ZigEmbeddedGroup/gauntlet/kicad/boards/backplane_42hp_v1/backplane_v1.kicad_pcb

## KiCad design kicad/boards/backplane_42hp_v1/backplane_v1.kicad_pcb (2026-10-21)

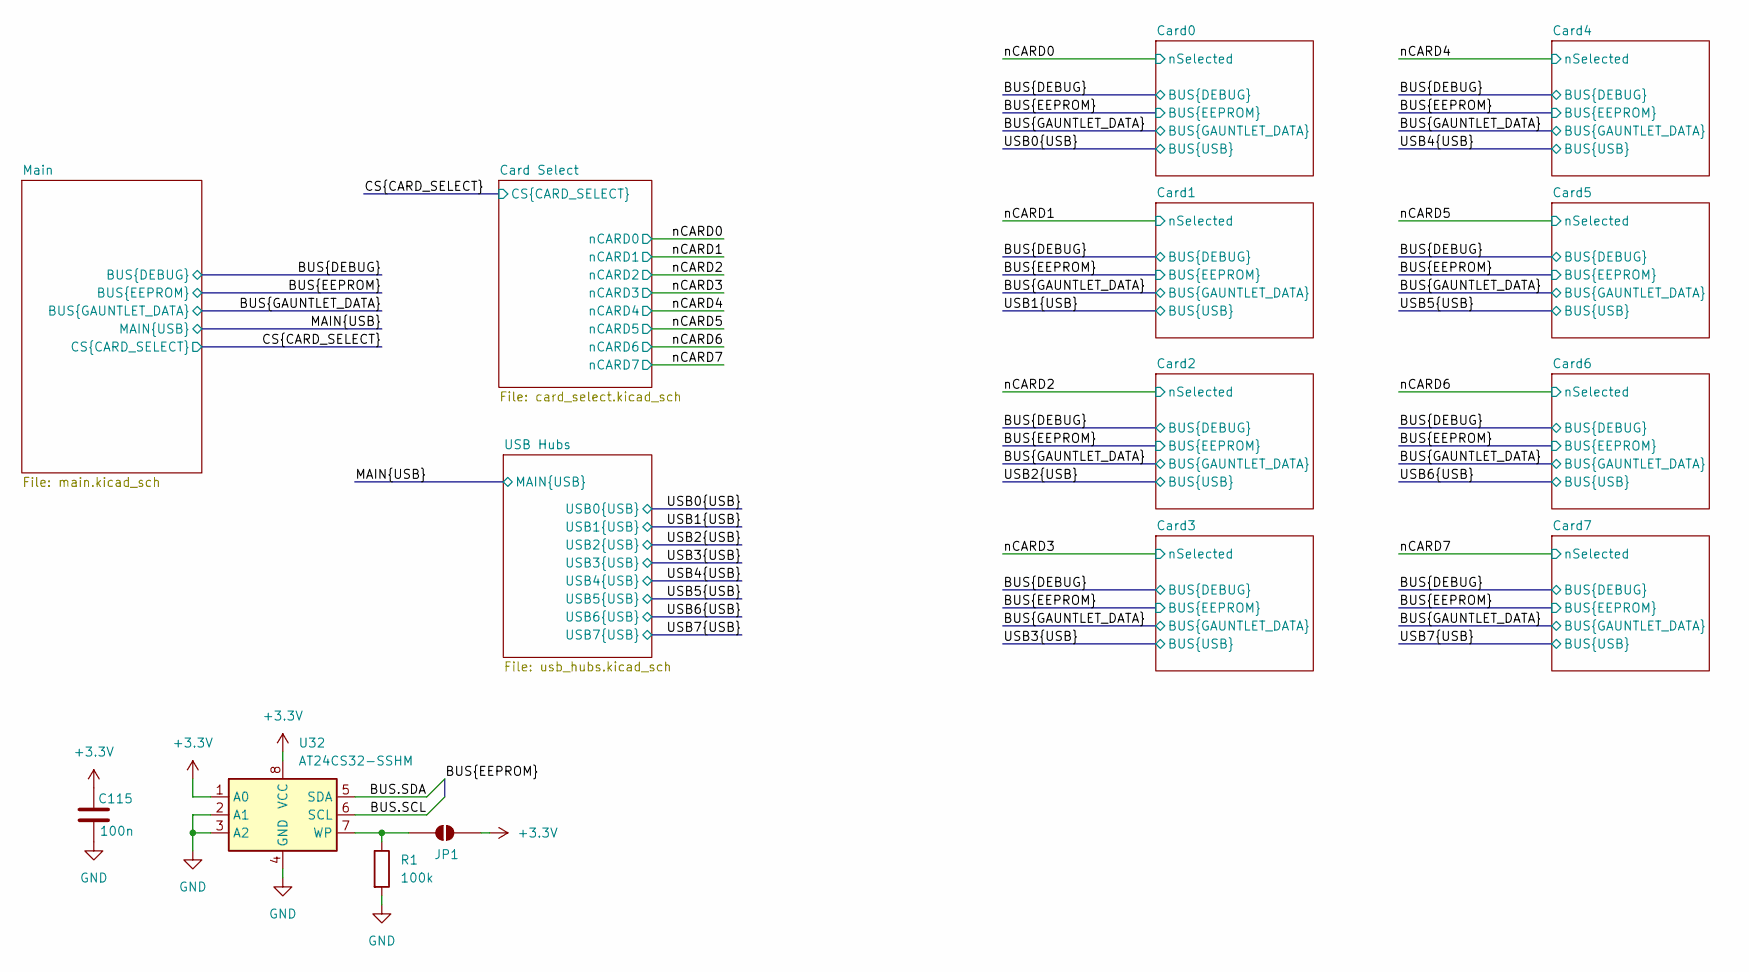
[picture p1: schematic backplane_v1.kicad_sch]

Parts:
C115: 100n; C_0603_1608Metric
JP1: SolderJumper_2_Open; SolderJumper-2_P1.3mm_Open_RoundedPad1.0x1.5mm
R1: 100k; R_0402_1005Metric
U32: AT24CS32-SSHM; SOIC-8_3.9x4.9mm_P1.27mm

Connections:
+3.3V: C115.1, JP1.2 (B), U32.1 (A0), U32.8 (VCC); also elsewhere on the board
/BUS.SCL: U32.6 (SCL); also elsewhere on the board
/BUS.SDA: U32.5 (SDA); also elsewhere on the board
GND: C115.2, R1.2, U32.2 (A1), U32.3 (A2), U32.4 (GND); also elsewhere on the board
unnamed: JP1.1 (A), R1.1, U32.7 (WP)

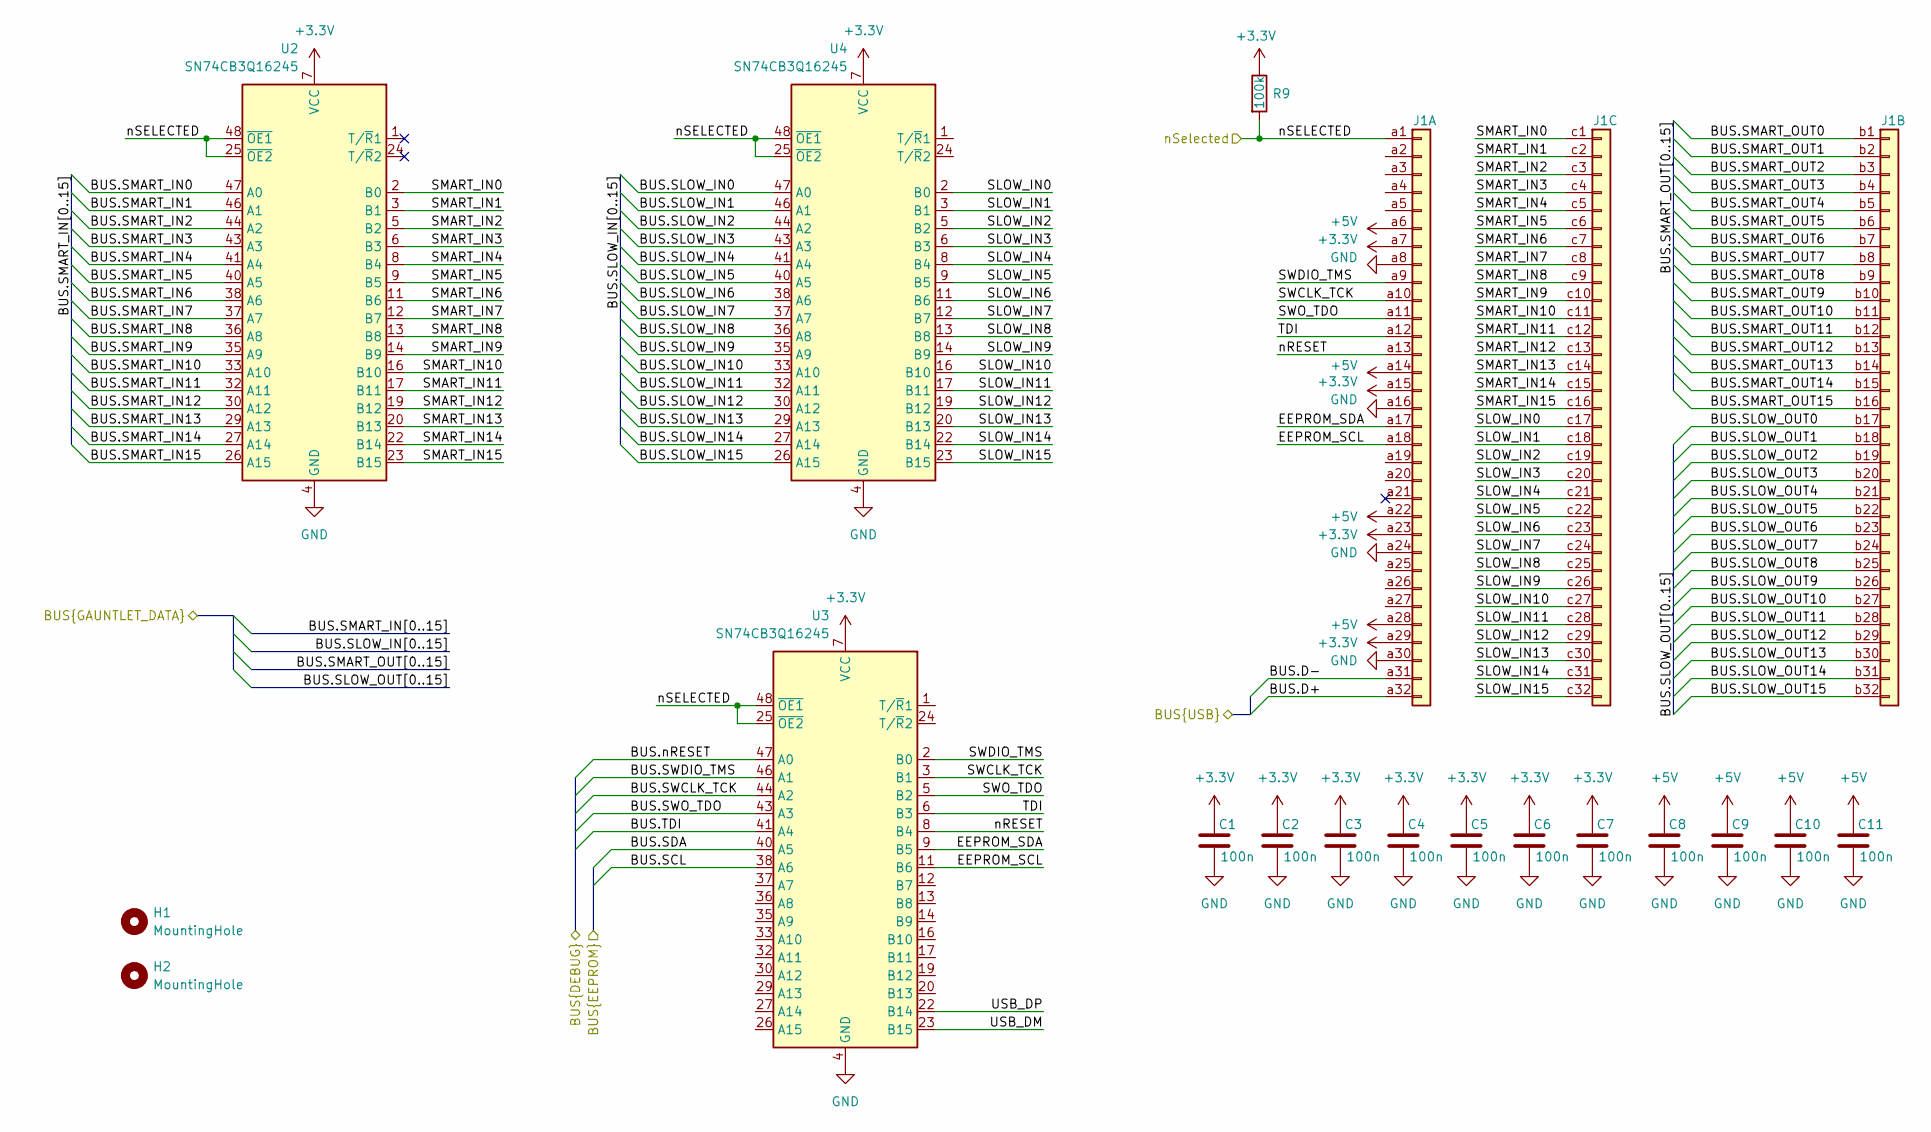
[picture p2: schematic Card Connector.kicad_sch]

Parts:
C1, C2, C3, C4, C5, C6, C7, C8, C9, C10, C11: 100n; C_0603_1608Metric
H1, H2: MountingHole; MountingHole_3.2mm_M3
J1: DIN41612_03x32_C_Split; DIN41612_C_3x32_Female_Vertical_THT
R9: 100k; R_0603_1608Metric
U2, U3, U4: SN74CB3Q16245; TSSOP-48_6.1x12.5mm_P0.5mm

Connections:
+3.3V: C1.1, C2.1, C3.1, C4.1, C5.1, C6.1, C7.1, J1.a7, J1.a15, J1.a23, J1.a29, R9.1, U2.7 (VCC), U2.18 (VCC), U2.31 (VCC), U2.42 (VCC), U3.7 (VCC), U3.18 (VCC), U3.31 (VCC), U3.42 (VCC), U4.7 (VCC), U4.18 (VCC), U4.31 (VCC), U4.42 (VCC); also elsewhere on the board
+5V: C8.1, C9.1, C10.1, C11.1, J1.a6, J1.a14, J1.a22, J1.a28; also elsewhere on the board
/BUS.SCL: U3.38 (A6); also elsewhere on the board
/BUS.SDA: U3.40 (A5); also elsewhere on the board
/BUS.SLOW_IN0: U4.47 (A0); also elsewhere on the board
/BUS.SLOW_IN1: U4.46 (A1); also elsewhere on the board
/BUS.SLOW_IN2: U4.44 (A2); also elsewhere on the board
/BUS.SLOW_IN3: U4.43 (A3); also elsewhere on the board
/BUS.SLOW_IN4: U4.41 (A4); also elsewhere on the board
/BUS.SLOW_IN5: U4.40 (A5); also elsewhere on the board
/BUS.SLOW_IN6: U4.38 (A6); also elsewhere on the board
/BUS.SLOW_IN7: U4.37 (A7); also elsewhere on the board
/BUS.SLOW_IN8: U4.36 (A8); also elsewhere on the board
/BUS.SLOW_IN9: U4.35 (A9); also elsewhere on the board
/BUS.SLOW_IN10: U4.33 (A10); also elsewhere on the board
/BUS.SLOW_IN11: U4.32 (A11); also elsewhere on the board
/BUS.SLOW_IN12: U4.30 (A12); also elsewhere on the board
/BUS.SLOW_IN13: U4.29 (A13); also elsewhere on the board
/BUS.SLOW_IN14: U4.27 (A14); also elsewhere on the board
/BUS.SLOW_IN15: U4.26 (A15); also elsewhere on the board
/BUS.SLOW_OUT0: J1.b17; also elsewhere on the board
/BUS.SLOW_OUT1: J1.b18; also elsewhere on the board
/BUS.SLOW_OUT2: J1.b19; also elsewhere on the board
/BUS.SLOW_OUT3: J1.b20; also elsewhere on the board
/BUS.SLOW_OUT4: J1.b21; also elsewhere on the board
/BUS.SLOW_OUT5: J1.b22; also elsewhere on the board
/BUS.SLOW_OUT6: J1.b23; also elsewhere on the board
/BUS.SLOW_OUT7: J1.b24; also elsewhere on the board
/BUS.SLOW_OUT8: J1.b25; also elsewhere on the board
/BUS.SLOW_OUT9: J1.b26; also elsewhere on the board
/BUS.SLOW_OUT10: J1.b27; also elsewhere on the board
/BUS.SLOW_OUT11: J1.b28; also elsewhere on the board
/BUS.SLOW_OUT12: J1.b29; also elsewhere on the board
/BUS.SLOW_OUT13: J1.b30; also elsewhere on the board
/BUS.SLOW_OUT14: J1.b31; also elsewhere on the board
/BUS.SLOW_OUT15: J1.b32; also elsewhere on the board
/BUS.SMART_IN0: U2.47 (A0); also elsewhere on the board
/BUS.SMART_IN1: U2.46 (A1); also elsewhere on the board
/BUS.SMART_IN2: U2.44 (A2); also elsewhere on the board
/BUS.SMART_IN3: U2.43 (A3); also elsewhere on the board
/BUS.SMART_IN4: U2.41 (A4); also elsewhere on the board
/BUS.SMART_IN5: U2.40 (A5); also elsewhere on the board
/BUS.SMART_IN6: U2.38 (A6); also elsewhere on the board
/BUS.SMART_IN7: U2.37 (A7); also elsewhere on the board
/BUS.SMART_IN8: U2.36 (A8); also elsewhere on the board
/BUS.SMART_IN9: U2.35 (A9); also elsewhere on the board
/BUS.SMART_IN10: U2.33 (A10); also elsewhere on the board
/BUS.SMART_IN11: U2.32 (A11); also elsewhere on the board
/BUS.SMART_IN12: U2.30 (A12); also elsewhere on the board
/BUS.SMART_IN13: U2.29 (A13); also elsewhere on the board
/BUS.SMART_IN14: U2.27 (A14); also elsewhere on the board
/BUS.SMART_IN15: U2.26 (A15); also elsewhere on the board
/BUS.SMART_OUT0: J1.b1; also elsewhere on the board
/BUS.SMART_OUT1: J1.b2; also elsewhere on the board
/BUS.SMART_OUT2: J1.b3; also elsewhere on the board
/BUS.SMART_OUT3: J1.b4; also elsewhere on the board
/BUS.SMART_OUT4: J1.b5; also elsewhere on the board
/BUS.SMART_OUT5: J1.b6; also elsewhere on the board
/BUS.SMART_OUT6: J1.b7; also elsewhere on the board
/BUS.SMART_OUT7: J1.b8; also elsewhere on the board
/BUS.SMART_OUT8: J1.b9; also elsewhere on the board
/BUS.SMART_OUT9: J1.b10; also elsewhere on the board
/BUS.SMART_OUT10: J1.b11; also elsewhere on the board
/BUS.SMART_OUT11: J1.b12; also elsewhere on the board
/BUS.SMART_OUT12: J1.b13; also elsewhere on the board
/BUS.SMART_OUT13: J1.b14; also elsewhere on the board
/BUS.SMART_OUT14: J1.b15; also elsewhere on the board
/BUS.SMART_OUT15: J1.b16; also elsewhere on the board
/BUS.SWCLK_TCK: U3.44 (A2); also elsewhere on the board
/BUS.SWDIO_TMS: U3.46 (A1); also elsewhere on the board
/BUS.SWO_TDO: U3.43 (A3); also elsewhere on the board
/BUS.TDI: U3.41 (A4); also elsewhere on the board
/BUS.nRESET: U3.47 (A0); also elsewhere on the board
/Card0/EEPROM_SCL: J1.a18, U3.11 (B6)
/Card0/EEPROM_SDA: J1.a17, U3.9 (B5)
/Card0/SLOW_IN0: J1.c17, U4.2 (B0)
/Card0/SLOW_IN1: J1.c18, U4.3 (B1)
/Card0/SLOW_IN2: J1.c19, U4.5 (B2)
/Card0/SLOW_IN3: J1.c20, U4.6 (B3)
/Card0/SLOW_IN4: J1.c21, U4.8 (B4)
/Card0/SLOW_IN5: J1.c22, U4.9 (B5)
/Card0/SLOW_IN6: J1.c23, U4.11 (B6)
/Card0/SLOW_IN7: J1.c24, U4.12 (B7)
/Card0/SLOW_IN8: J1.c25, U4.13 (B8)
/Card0/SLOW_IN9: J1.c26, U4.14 (B9)
/Card0/SLOW_IN10: J1.c27, U4.16 (B10)
/Card0/SLOW_IN11: J1.c28, U4.17 (B11)
/Card0/SLOW_IN12: J1.c29, U4.19 (B12)
/Card0/SLOW_IN13: J1.c30, U4.20 (B13)
/Card0/SLOW_IN14: J1.c31, U4.22 (B14)
/Card0/SLOW_IN15: J1.c32, U4.23 (B15)
/Card0/SMART_IN0: J1.c1, U2.2 (B0)
/Card0/SMART_IN1: J1.c2, U2.3 (B1)
/Card0/SMART_IN2: J1.c3, U2.5 (B2)
/Card0/SMART_IN3: J1.c4, U2.6 (B3)
/Card0/SMART_IN4: J1.c5, U2.8 (B4)
/Card0/SMART_IN5: J1.c6, U2.9 (B5)
/Card0/SMART_IN6: J1.c7, U2.11 (B6)
/Card0/SMART_IN7: J1.c8, U2.12 (B7)
/Card0/SMART_IN8: J1.c9, U2.13 (B8)
/Card0/SMART_IN9: J1.c10, U2.14 (B9)
/Card0/SMART_IN10: J1.c11, U2.16 (B10)
/Card0/SMART_IN11: J1.c12, U2.17 (B11)
/Card0/SMART_IN12: J1.c13, U2.19 (B12)
/Card0/SMART_IN13: J1.c14, U2.20 (B13)
/Card0/SMART_IN14: J1.c15, U2.22 (B14)
/Card0/SMART_IN15: J1.c16, U2.23 (B15)
/Card0/SWCLK_TCK: J1.a10, U3.3 (B1)
/Card0/SWDIO_TMS: J1.a9, U3.2 (B0)
/Card0/SWO_TDO: J1.a11, U3.5 (B2)
/Card0/TDI: J1.a12, U3.6 (B3)
/Card0/USB_DM: U3.23 (B15)
/Card0/USB_DP: U3.22 (B14)
/Card0/nRESET: J1.a13, U3.8 (B4)
/USB0.D+: J1.a32; also elsewhere on the board
/USB0.D-: J1.a31; also elsewhere on the board
/nCARD0: J1.a1, R9.2, U2.25 (~OE2), U2.48 (~OE1), U3.25 (~OE2), U3.48 (~OE1), U4.25 (~OE2), U4.48 (~OE1); also elsewhere on the board
GND: C1.2, C2.2, C3.2, C4.2, C5.2, C6.2, C7.2, C8.2, C9.2, C10.2, C11.2, J1.a8, J1.a16, J1.a24, J1.a30, U2.4 (GND), U2.10 (GND), U2.15 (GND), U2.21 (GND), U2.28 (GND), U2.34 (GND), U2.39 (GND), U2.45 (GND), U3.4 (GND), U3.10 (GND), U3.15 (GND), U3.21 (GND), U3.28 (GND), U3.34 (GND), U3.39 (GND), U3.45 (GND), U4.4 (GND), U4.10 (GND), U4.15 (GND), U4.21 (GND), U4.28 (GND), U4.34 (GND), U4.39 (GND), U4.45 (GND); also elsewhere on the board

Parts of its further copies:
C16, C17, C18, C19, C20, C21, C22, C23, C24, C25, C26, C27, C28, C29, C30, C31, C32, C33, C34, C35, C36, C37, C38, C39, C40, C41, C42, C43, C44, C45, C46, C47, C48, C49, C50, C51, C52, C53, C54, C55, C56, C57, C58, C59, C60, C61, C62, C63, C64, C65, C66, C67, C68, C69, C70, C71, C72, C73, C74, C75, C76, C77, C78, C79, C80, C81, C82, C83, C84, C85, C86, C87, C88, C89, C90, C91, C92: 100n; C_0603_1608Metric
H3, H4, H5, H6, H7, H8, H9, H10, H11, H12, H13, H14, H15, H16: MountingHole; MountingHole_3.2mm_M3
J3, J4, J5, J6, J7, J8, J9: DIN41612_03x32_C_Split; DIN41612_C_3x32_Female_Vertical_THT
R10, R11, R12, R13, R14, R15, R16: 100k; R_0603_1608Metric
U5, U6, U7, U11, U12, U13, U14, U15, U16, U17, U18, U19, U20, U21, U22, U23, U24, U25, U26, U27, U28: SN74CB3Q16245; TSSOP-48_6.1x12.5mm_P0.5mm

Connections of its further copies:
+3.3V: C16.1, C17.1, C18.1, C19.1, C20.1, C21.1, C22.1, C27.1, C28.1, C29.1, C30.1, C31.1, C32.1, C33.1, C38.1, C39.1, C40.1, C41.1, C42.1, C43.1, C44.1, C49.1, C50.1, C51.1, C52.1, C53.1, C54.1, C55.1, C60.1, C61.1, C62.1, C63.1, C64.1, C65.1, C66.1, C71.1, C72.1, C73.1, C74.1, C75.1, C76.1, C77.1, C82.1, C83.1, C84.1, C85.1, C86.1, C87.1, C88.1, J3.a7, J3.a15, J3.a23, J3.a29, J4.a7, J4.a15, J4.a23, J4.a29, J5.a7, J5.a15, J5.a23, J5.a29, J6.a7, J6.a15, J6.a23, J6.a29, J7.a7, J7.a15, J7.a23, J7.a29, J8.a7, J8.a15, J8.a23, J8.a29, J9.a7, J9.a15, J9.a23, J9.a29, R10.1, R11.1, R12.1, R13.1, R14.1, R15.1, R16.1, U5.7 (VCC), U5.18 (VCC), U5.31 (VCC), U5.42 (VCC), U6.7 (VCC), U6.18 (VCC), U6.31 (VCC), U6.42 (VCC), U7.7 (VCC), U7.18 (VCC), U7.31 (VCC), U7.42 (VCC), U11.7 (VCC), U11.18 (VCC), U11.31 (VCC), U11.42 (VCC), U12.7 (VCC), U12.18 (VCC), U12.31 (VCC), U12.42 (VCC), U13.7 (VCC), U13.18 (VCC), U13.31 (VCC), U13.42 (VCC), U14.7 (VCC), U14.18 (VCC), U14.31 (VCC), U14.42 (VCC), U15.7 (VCC), U15.18 (VCC), U15.31 (VCC), U15.42 (VCC), U16.7 (VCC), U16.18 (VCC), U16.31 (VCC), U16.42 (VCC), U17.7 (VCC), U17.18 (VCC), U17.31 (VCC), U17.42 (VCC), U18.7 (VCC), U18.18 (VCC), U18.31 (VCC), U18.42 (VCC), U19.7 (VCC), U19.18 (VCC), U19.31 (VCC), U19.42 (VCC), U20.7 (VCC), U20.18 (VCC), U20.31 (VCC), U20.42 (VCC), U21.7 (VCC), U21.18 (VCC), U21.31 (VCC), U21.42 (VCC), U22.7 (VCC), U22.18 (VCC), U22.31 (VCC), U22.42 (VCC), U23.7 (VCC), U23.18 (VCC), U23.31 (VCC), U23.42 (VCC), U24.7 (VCC), U24.18 (VCC), U24.31 (VCC), U24.42 (VCC), U25.7 (VCC), U25.18 (VCC), U25.31 (VCC), U25.42 (VCC), U26.7 (VCC), U26.18 (VCC), U26.31 (VCC), U26.42 (VCC), U27.7 (VCC), U27.18 (VCC), U27.31 (VCC), U27.42 (VCC), U28.7 (VCC), U28.18 (VCC), U28.31 (VCC), U28.42 (VCC); also elsewhere on the board
+5V: C23.1, C24.1, C25.1, C26.1, C34.1, C35.1, C36.1, C37.1, C45.1, C46.1, C47.1, C48.1, C56.1, C57.1, C58.1, C59.1, C67.1, C68.1, C69.1, C70.1, C78.1, C79.1, C80.1, C81.1, C89.1, C90.1, C91.1, C92.1, J3.a6, J3.a14, J3.a22, J3.a28, J4.a6, J4.a14, J4.a22, J4.a28, J5.a6, J5.a14, J5.a22, J5.a28, J6.a6, J6.a14, J6.a22, J6.a28, J7.a6, J7.a14, J7.a22, J7.a28, J8.a6, J8.a14, J8.a22, J8.a28, J9.a6, J9.a14, J9.a22, J9.a28; also elsewhere on the board
/BUS.SCL: U6.38 (A6), U12.38 (A6), U15.38 (A6), U18.38 (A6), U21.38 (A6), U24.38 (A6), U27.38 (A6); also elsewhere on the board
/BUS.SDA: U6.40 (A5), U12.40 (A5), U15.40 (A5), U18.40 (A5), U21.40 (A5), U24.40 (A5), U27.40 (A5); also elsewhere on the board
/BUS.SLOW_IN0: U7.47 (A0), U13.47 (A0), U16.47 (A0), U19.47 (A0), U22.47 (A0), U25.47 (A0), U28.47 (A0); also elsewhere on the board
/BUS.SLOW_IN1: U7.46 (A1), U13.46 (A1), U16.46 (A1), U19.46 (A1), U22.46 (A1), U25.46 (A1), U28.46 (A1); also elsewhere on the board
/BUS.SLOW_IN2: U7.44 (A2), U13.44 (A2), U16.44 (A2), U19.44 (A2), U22.44 (A2), U25.44 (A2), U28.44 (A2); also elsewhere on the board
/BUS.SLOW_IN3: U7.43 (A3), U13.43 (A3), U16.43 (A3), U19.43 (A3), U22.43 (A3), U25.43 (A3), U28.43 (A3); also elsewhere on the board
/BUS.SLOW_IN4: U7.41 (A4), U13.41 (A4), U16.41 (A4), U19.41 (A4), U22.41 (A4), U25.41 (A4), U28.41 (A4); also elsewhere on the board
/BUS.SLOW_IN5: U7.40 (A5), U13.40 (A5), U16.40 (A5), U19.40 (A5), U22.40 (A5), U25.40 (A5), U28.40 (A5); also elsewhere on the board
/BUS.SLOW_IN6: U7.38 (A6), U13.38 (A6), U16.38 (A6), U19.38 (A6), U22.38 (A6), U25.38 (A6), U28.38 (A6); also elsewhere on the board
/BUS.SLOW_IN7: U7.37 (A7), U13.37 (A7), U16.37 (A7), U19.37 (A7), U22.37 (A7), U25.37 (A7), U28.37 (A7); also elsewhere on the board
/BUS.SLOW_IN8: U7.36 (A8), U13.36 (A8), U16.36 (A8), U19.36 (A8), U22.36 (A8), U25.36 (A8), U28.36 (A8); also elsewhere on the board
/BUS.SLOW_IN9: U7.35 (A9), U13.35 (A9), U16.35 (A9), U19.35 (A9), U22.35 (A9), U25.35 (A9), U28.35 (A9); also elsewhere on the board
/BUS.SLOW_IN10: U7.33 (A10), U13.33 (A10), U16.33 (A10), U19.33 (A10), U22.33 (A10), U25.33 (A10), U28.33 (A10); also elsewhere on the board
/BUS.SLOW_IN11: U7.32 (A11), U13.32 (A11), U16.32 (A11), U19.32 (A11), U22.32 (A11), U25.32 (A11), U28.32 (A11); also elsewhere on the board
/BUS.SLOW_IN12: U7.30 (A12), U13.30 (A12), U16.30 (A12), U19.30 (A12), U22.30 (A12), U25.30 (A12), U28.30 (A12); also elsewhere on the board
/BUS.SLOW_IN13: U7.29 (A13), U13.29 (A13), U16.29 (A13), U19.29 (A13), U22.29 (A13), U25.29 (A13), U28.29 (A13); also elsewhere on the board
/BUS.SLOW_IN14: U7.27 (A14), U13.27 (A14), U16.27 (A14), U19.27 (A14), U22.27 (A14), U25.27 (A14), U28.27 (A14); also elsewhere on the board
/BUS.SLOW_IN15: U7.26 (A15), U13.26 (A15), U16.26 (A15), U19.26 (A15), U22.26 (A15), U25.26 (A15), U28.26 (A15); also elsewhere on the board
/BUS.SLOW_OUT0: J3.b17, J4.b17, J5.b17, J6.b17, J7.b17, J8.b17, J9.b17; also elsewhere on the board
/BUS.SLOW_OUT1: J3.b18, J4.b18, J5.b18, J6.b18, J7.b18, J8.b18, J9.b18; also elsewhere on the board
/BUS.SLOW_OUT2: J3.b19, J4.b19, J5.b19, J6.b19, J7.b19, J8.b19, J9.b19; also elsewhere on the board
/BUS.SLOW_OUT3: J3.b20, J4.b20, J5.b20, J6.b20, J7.b20, J8.b20, J9.b20; also elsewhere on the board
/BUS.SLOW_OUT4: J3.b21, J4.b21, J5.b21, J6.b21, J7.b21, J8.b21, J9.b21; also elsewhere on the board
/BUS.SLOW_OUT5: J3.b22, J4.b22, J5.b22, J6.b22, J7.b22, J8.b22, J9.b22; also elsewhere on the board
/BUS.SLOW_OUT6: J3.b23, J4.b23, J5.b23, J6.b23, J7.b23, J8.b23, J9.b23; also elsewhere on the board
/BUS.SLOW_OUT7: J3.b24, J4.b24, J5.b24, J6.b24, J7.b24, J8.b24, J9.b24; also elsewhere on the board
/BUS.SLOW_OUT8: J3.b25, J4.b25, J5.b25, J6.b25, J7.b25, J8.b25, J9.b25; also elsewhere on the board
/BUS.SLOW_OUT9: J3.b26, J4.b26, J5.b26, J6.b26, J7.b26, J8.b26, J9.b26; also elsewhere on the board
/BUS.SLOW_OUT10: J3.b27, J4.b27, J5.b27, J6.b27, J7.b27, J8.b27, J9.b27; also elsewhere on the board
/BUS.SLOW_OUT11: J3.b28, J4.b28, J5.b28, J6.b28, J7.b28, J8.b28, J9.b28; also elsewhere on the board
/BUS.SLOW_OUT12: J3.b29, J4.b29, J5.b29, J6.b29, J7.b29, J8.b29, J9.b29; also elsewhere on the board
/BUS.SLOW_OUT13: J3.b30, J4.b30, J5.b30, J6.b30, J7.b30, J8.b30, J9.b30; also elsewhere on the board
/BUS.SLOW_OUT14: J3.b31, J4.b31, J5.b31, J6.b31, J7.b31, J8.b31, J9.b31; also elsewhere on the board
/BUS.SLOW_OUT15: J3.b32, J4.b32, J5.b32, J6.b32, J7.b32, J8.b32, J9.b32; also elsewhere on the board
/BUS.SMART_IN0: U5.47 (A0), U11.47 (A0), U14.47 (A0), U17.47 (A0), U20.47 (A0), U23.47 (A0), U26.47 (A0); also elsewhere on the board
/BUS.SMART_IN1: U5.46 (A1), U11.46 (A1), U14.46 (A1), U17.46 (A1), U20.46 (A1), U23.46 (A1), U26.46 (A1); also elsewhere on the board
/BUS.SMART_IN2: U5.44 (A2), U11.44 (A2), U14.44 (A2), U17.44 (A2), U20.44 (A2), U23.44 (A2), U26.44 (A2); also elsewhere on the board
/BUS.SMART_IN3: U5.43 (A3), U11.43 (A3), U14.43 (A3), U17.43 (A3), U20.43 (A3), U23.43 (A3), U26.43 (A3); also elsewhere on the board
/BUS.SMART_IN4: U5.41 (A4), U11.41 (A4), U14.41 (A4), U17.41 (A4), U20.41 (A4), U23.41 (A4), U26.41 (A4); also elsewhere on the board
/BUS.SMART_IN5: U5.40 (A5), U11.40 (A5), U14.40 (A5), U17.40 (A5), U20.40 (A5), U23.40 (A5), U26.40 (A5); also elsewhere on the board
/BUS.SMART_IN6: U5.38 (A6), U11.38 (A6), U14.38 (A6), U17.38 (A6), U20.38 (A6), U23.38 (A6), U26.38 (A6); also elsewhere on the board
/BUS.SMART_IN7: U5.37 (A7), U11.37 (A7), U14.37 (A7), U17.37 (A7), U20.37 (A7), U23.37 (A7), U26.37 (A7); also elsewhere on the board
/BUS.SMART_IN8: U5.36 (A8), U11.36 (A8), U14.36 (A8), U17.36 (A8), U20.36 (A8), U23.36 (A8), U26.36 (A8); also elsewhere on the board
/BUS.SMART_IN9: U5.35 (A9), U11.35 (A9), U14.35 (A9), U17.35 (A9), U20.35 (A9), U23.35 (A9), U26.35 (A9); also elsewhere on the board
/BUS.SMART_IN10: U5.33 (A10), U11.33 (A10), U14.33 (A10), U17.33 (A10), U20.33 (A10), U23.33 (A10), U26.33 (A10); also elsewhere on the board
/BUS.SMART_IN11: U5.32 (A11), U11.32 (A11), U14.32 (A11), U17.32 (A11), U20.32 (A11), U23.32 (A11), U26.32 (A11); also elsewhere on the board
/BUS.SMART_IN12: U5.30 (A12), U11.30 (A12), U14.30 (A12), U17.30 (A12), U20.30 (A12), U23.30 (A12), U26.30 (A12); also elsewhere on the board
/BUS.SMART_IN13: U5.29 (A13), U11.29 (A13), U14.29 (A13), U17.29 (A13), U20.29 (A13), U23.29 (A13), U26.29 (A13); also elsewhere on the board
/BUS.SMART_IN14: U5.27 (A14), U11.27 (A14), U14.27 (A14), U17.27 (A14), U20.27 (A14), U23.27 (A14), U26.27 (A14); also elsewhere on the board
/BUS.SMART_IN15: U5.26 (A15), U11.26 (A15), U14.26 (A15), U17.26 (A15), U20.26 (A15), U23.26 (A15), U26.26 (A15); also elsewhere on the board
/BUS.SMART_OUT0: J3.b1, J4.b1, J5.b1, J6.b1, J7.b1, J8.b1, J9.b1; also elsewhere on the board
/BUS.SMART_OUT1: J3.b2, J4.b2, J5.b2, J6.b2, J7.b2, J8.b2, J9.b2; also elsewhere on the board
/BUS.SMART_OUT2: J3.b3, J4.b3, J5.b3, J6.b3, J7.b3, J8.b3, J9.b3; also elsewhere on the board
/BUS.SMART_OUT3: J3.b4, J4.b4, J5.b4, J6.b4, J7.b4, J8.b4, J9.b4; also elsewhere on the board
/BUS.SMART_OUT4: J3.b5, J4.b5, J5.b5, J6.b5, J7.b5, J8.b5, J9.b5; also elsewhere on the board
/BUS.SMART_OUT5: J3.b6, J4.b6, J5.b6, J6.b6, J7.b6, J8.b6, J9.b6; also elsewhere on the board
/BUS.SMART_OUT6: J3.b7, J4.b7, J5.b7, J6.b7, J7.b7, J8.b7, J9.b7; also elsewhere on the board
/BUS.SMART_OUT7: J3.b8, J4.b8, J5.b8, J6.b8, J7.b8, J8.b8, J9.b8; also elsewhere on the board
/BUS.SMART_OUT8: J3.b9, J4.b9, J5.b9, J6.b9, J7.b9, J8.b9, J9.b9; also elsewhere on the board
/BUS.SMART_OUT9: J3.b10, J4.b10, J5.b10, J6.b10, J7.b10, J8.b10, J9.b10; also elsewhere on the board
/BUS.SMART_OUT10: J3.b11, J4.b11, J5.b11, J6.b11, J7.b11, J8.b11, J9.b11; also elsewhere on the board
/BUS.SMART_OUT11: J3.b12, J4.b12, J5.b12, J6.b12, J7.b12, J8.b12, J9.b12; also elsewhere on the board
/BUS.SMART_OUT12: J3.b13, J4.b13, J5.b13, J6.b13, J7.b13, J8.b13, J9.b13; also elsewhere on the board
/BUS.SMART_OUT13: J3.b14, J4.b14, J5.b14, J6.b14, J7.b14, J8.b14, J9.b14; also elsewhere on the board
/BUS.SMART_OUT14: J3.b15, J4.b15, J5.b15, J6.b15, J7.b15, J8.b15, J9.b15; also elsewhere on the board
/BUS.SMART_OUT15: J3.b16, J4.b16, J5.b16, J6.b16, J7.b16, J8.b16, J9.b16; also elsewhere on the board
/BUS.SWCLK_TCK: U6.44 (A2), U12.44 (A2), U15.44 (A2), U18.44 (A2), U21.44 (A2), U24.44 (A2), U27.44 (A2); also elsewhere on the board
/BUS.SWDIO_TMS: U6.46 (A1), U12.46 (A1), U15.46 (A1), U18.46 (A1), U21.46 (A1), U24.46 (A1), U27.46 (A1); also elsewhere on the board
/BUS.SWO_TDO: U6.43 (A3), U12.43 (A3), U15.43 (A3), U18.43 (A3), U21.43 (A3), U24.43 (A3), U27.43 (A3); also elsewhere on the board
/BUS.TDI: U6.41 (A4), U12.41 (A4), U15.41 (A4), U18.41 (A4), U21.41 (A4), U24.41 (A4), U27.41 (A4); also elsewhere on the board
/BUS.nRESET: U6.47 (A0), U12.47 (A0), U15.47 (A0), U18.47 (A0), U21.47 (A0), U24.47 (A0), U27.47 (A0); also elsewhere on the board
/Card1/EEPROM_SCL: J3.a18, U6.11 (B6)
/Card1/EEPROM_SDA: J3.a17, U6.9 (B5)
/Card1/SLOW_IN0: J3.c17, U7.2 (B0)
/Card1/SLOW_IN1: J3.c18, U7.3 (B1)
/Card1/SLOW_IN2: J3.c19, U7.5 (B2)
/Card1/SLOW_IN3: J3.c20, U7.6 (B3)
/Card1/SLOW_IN4: J3.c21, U7.8 (B4)
/Card1/SLOW_IN5: J3.c22, U7.9 (B5)
/Card1/SLOW_IN6: J3.c23, U7.11 (B6)
/Card1/SLOW_IN7: J3.c24, U7.12 (B7)
/Card1/SLOW_IN8: J3.c25, U7.13 (B8)
/Card1/SLOW_IN9: J3.c26, U7.14 (B9)
/Card1/SLOW_IN10: J3.c27, U7.16 (B10)
/Card1/SLOW_IN11: J3.c28, U7.17 (B11)
/Card1/SLOW_IN12: J3.c29, U7.19 (B12)
/Card1/SLOW_IN13: J3.c30, U7.20 (B13)
/Card1/SLOW_IN14: J3.c31, U7.22 (B14)
/Card1/SLOW_IN15: J3.c32, U7.23 (B15)
/Card1/SMART_IN0: J3.c1, U5.2 (B0)
/Card1/SMART_IN1: J3.c2, U5.3 (B1)
/Card1/SMART_IN2: J3.c3, U5.5 (B2)
/Card1/SMART_IN3: J3.c4, U5.6 (B3)
/Card1/SMART_IN4: J3.c5, U5.8 (B4)
/Card1/SMART_IN5: J3.c6, U5.9 (B5)
/Card1/SMART_IN6: J3.c7, U5.11 (B6)
/Card1/SMART_IN7: J3.c8, U5.12 (B7)
/Card1/SMART_IN8: J3.c9, U5.13 (B8)
/Card1/SMART_IN9: J3.c10, U5.14 (B9)
/Card1/SMART_IN10: J3.c11, U5.16 (B10)
/Card1/SMART_IN11: J3.c12, U5.17 (B11)
/Card1/SMART_IN12: J3.c13, U5.19 (B12)
/Card1/SMART_IN13: J3.c14, U5.20 (B13)
/Card1/SMART_IN14: J3.c15, U5.22 (B14)
/Card1/SMART_IN15: J3.c16, U5.23 (B15)
/Card1/SWCLK_TCK: J3.a10, U6.3 (B1)
/Card1/SWDIO_TMS: J3.a9, U6.2 (B0)
/Card1/SWO_TDO: J3.a11, U6.5 (B2)
/Card1/TDI: J3.a12, U6.6 (B3)
/Card1/USB_DM: U6.23 (B15)
/Card1/USB_DP: U6.22 (B14)
/Card1/nRESET: J3.a13, U6.8 (B4)
/Card2/EEPROM_SCL: J4.a18, U12.11 (B6)
/Card2/EEPROM_SDA: J4.a17, U12.9 (B5)
/Card2/SLOW_IN0: J4.c17, U13.2 (B0)
/Card2/SLOW_IN1: J4.c18, U13.3 (B1)
/Card2/SLOW_IN2: J4.c19, U13.5 (B2)
/Card2/SLOW_IN3: J4.c20, U13.6 (B3)
/Card2/SLOW_IN4: J4.c21, U13.8 (B4)
/Card2/SLOW_IN5: J4.c22, U13.9 (B5)
/Card2/SLOW_IN6: J4.c23, U13.11 (B6)
/Card2/SLOW_IN7: J4.c24, U13.12 (B7)
/Card2/SLOW_IN8: J4.c25, U13.13 (B8)
/Card2/SLOW_IN9: J4.c26, U13.14 (B9)
/Card2/SLOW_IN10: J4.c27, U13.16 (B10)
/Card2/SLOW_IN11: J4.c28, U13.17 (B11)
/Card2/SLOW_IN12: J4.c29, U13.19 (B12)
/Card2/SLOW_IN13: J4.c30, U13.20 (B13)
/Card2/SLOW_IN14: J4.c31, U13.22 (B14)
/Card2/SLOW_IN15: J4.c32, U13.23 (B15)
/Card2/SMART_IN0: J4.c1, U11.2 (B0)
/Card2/SMART_IN1: J4.c2, U11.3 (B1)
/Card2/SMART_IN2: J4.c3, U11.5 (B2)
/Card2/SMART_IN3: J4.c4, U11.6 (B3)
/Card2/SMART_IN4: J4.c5, U11.8 (B4)
/Card2/SMART_IN5: J4.c6, U11.9 (B5)
/Card2/SMART_IN6: J4.c7, U11.11 (B6)
/Card2/SMART_IN7: J4.c8, U11.12 (B7)
/Card2/SMART_IN8: J4.c9, U11.13 (B8)
/Card2/SMART_IN9: J4.c10, U11.14 (B9)
/Card2/SMART_IN10: J4.c11, U11.16 (B10)
/Card2/SMART_IN11: J4.c12, U11.17 (B11)
/Card2/SMART_IN12: J4.c13, U11.19 (B12)
/Card2/SMART_IN13: J4.c14, U11.20 (B13)
/Card2/SMART_IN14: J4.c15, U11.22 (B14)
/Card2/SMART_IN15: J4.c16, U11.23 (B15)
/Card2/SWCLK_TCK: J4.a10, U12.3 (B1)
/Card2/SWDIO_TMS: J4.a9, U12.2 (B0)
/Card2/SWO_TDO: J4.a11, U12.5 (B2)
/Card2/TDI: J4.a12, U12.6 (B3)
/Card2/USB_DM: U12.23 (B15)
/Card2/USB_DP: U12.22 (B14)
/Card2/nRESET: J4.a13, U12.8 (B4)
/Card3/EEPROM_SCL: J5.a18, U15.11 (B6)
/Card3/EEPROM_SDA: J5.a17, U15.9 (B5)
/Card3/SLOW_IN0: J5.c17, U16.2 (B0)
/Card3/SLOW_IN1: J5.c18, U16.3 (B1)
/Card3/SLOW_IN2: J5.c19, U16.5 (B2)
/Card3/SLOW_IN3: J5.c20, U16.6 (B3)
/Card3/SLOW_IN4: J5.c21, U16.8 (B4)
/Card3/SLOW_IN5: J5.c22, U16.9 (B5)
/Card3/SLOW_IN6: J5.c23, U16.11 (B6)
/Card3/SLOW_IN7: J5.c24, U16.12 (B7)
/Card3/SLOW_IN8: J5.c25, U16.13 (B8)
/Card3/SLOW_IN9: J5.c26, U16.14 (B9)
/Card3/SLOW_IN10: J5.c27, U16.16 (B10)
/Card3/SLOW_IN11: J5.c28, U16.17 (B11)
/Card3/SLOW_IN12: J5.c29, U16.19 (B12)
/Card3/SLOW_IN13: J5.c30, U16.20 (B13)
/Card3/SLOW_IN14: J5.c31, U16.22 (B14)
/Card3/SLOW_IN15: J5.c32, U16.23 (B15)
/Card3/SMART_IN0: J5.c1, U14.2 (B0)
/Card3/SMART_IN1: J5.c2, U14.3 (B1)
/Card3/SMART_IN2: J5.c3, U14.5 (B2)
/Card3/SMART_IN3: J5.c4, U14.6 (B3)
/Card3/SMART_IN4: J5.c5, U14.8 (B4)
/Card3/SMART_IN5: J5.c6, U14.9 (B5)
/Card3/SMART_IN6: J5.c7, U14.11 (B6)
/Card3/SMART_IN7: J5.c8, U14.12 (B7)
/Card3/SMART_IN8: J5.c9, U14.13 (B8)
/Card3/SMART_IN9: J5.c10, U14.14 (B9)
/Card3/SMART_IN10: J5.c11, U14.16 (B10)
/Card3/SMART_IN11: J5.c12, U14.17 (B11)
/Card3/SMART_IN12: J5.c13, U14.19 (B12)
/Card3/SMART_IN13: J5.c14, U14.20 (B13)
/Card3/SMART_IN14: J5.c15, U14.22 (B14)
/Card3/SMART_IN15: J5.c16, U14.23 (B15)
/Card3/SWCLK_TCK: J5.a10, U15.3 (B1)
/Card3/SWDIO_TMS: J5.a9, U15.2 (B0)
/Card3/SWO_TDO: J5.a11, U15.5 (B2)
/Card3/TDI: J5.a12, U15.6 (B3)
/Card3/USB_DM: U15.23 (B15)
/Card3/USB_DP: U15.22 (B14)
/Card3/nRESET: J5.a13, U15.8 (B4)
/Card4/EEPROM_SCL: J6.a18, U18.11 (B6)
/Card4/EEPROM_SDA: J6.a17, U18.9 (B5)
/Card4/SLOW_IN0: J6.c17, U19.2 (B0)
/Card4/SLOW_IN1: J6.c18, U19.3 (B1)
/Card4/SLOW_IN2: J6.c19, U19.5 (B2)
/Card4/SLOW_IN3: J6.c20, U19.6 (B3)
/Card4/SLOW_IN4: J6.c21, U19.8 (B4)
/Card4/SLOW_IN5: J6.c22, U19.9 (B5)
/Card4/SLOW_IN6: J6.c23, U19.11 (B6)
/Card4/SLOW_IN7: J6.c24, U19.12 (B7)
/Card4/SLOW_IN8: J6.c25, U19.13 (B8)
/Card4/SLOW_IN9: J6.c26, U19.14 (B9)
/Card4/SLOW_IN10: J6.c27, U19.16 (B10)
/Card4/SLOW_IN11: J6.c28, U19.17 (B11)
/Card4/SLOW_IN12: J6.c29, U19.19 (B12)
/Card4/SLOW_IN13: J6.c30, U19.20 (B13)
/Card4/SLOW_IN14: J6.c31, U19.22 (B14)
/Card4/SLOW_IN15: J6.c32, U19.23 (B15)
/Card4/SMART_IN0: J6.c1, U17.2 (B0)
/Card4/SMART_IN1: J6.c2, U17.3 (B1)
/Card4/SMART_IN2: J6.c3, U17.5 (B2)
/Card4/SMART_IN3: J6.c4, U17.6 (B3)
/Card4/SMART_IN4: J6.c5, U17.8 (B4)
/Card4/SMART_IN5: J6.c6, U17.9 (B5)
/Card4/SMART_IN6: J6.c7, U17.11 (B6)
/Card4/SMART_IN7: J6.c8, U17.12 (B7)
/Card4/SMART_IN8: J6.c9, U17.13 (B8)
/Card4/SMART_IN9: J6.c10, U17.14 (B9)
/Card4/SMART_IN10: J6.c11, U17.16 (B10)
/Card4/SMART_IN11: J6.c12, U17.17 (B11)
/Card4/SMART_IN12: J6.c13, U17.19 (B12)
/Card4/SMART_IN13: J6.c14, U17.20 (B13)
/Card4/SMART_IN14: J6.c15, U17.22 (B14)
/Card4/SMART_IN15: J6.c16, U17.23 (B15)
/Card4/SWCLK_TCK: J6.a10, U18.3 (B1)
/Card4/SWDIO_TMS: J6.a9, U18.2 (B0)
/Card4/SWO_TDO: J6.a11, U18.5 (B2)
/Card4/TDI: J6.a12, U18.6 (B3)
/Card4/USB_DM: U18.23 (B15)
/Card4/USB_DP: U18.22 (B14)
/Card4/nRESET: J6.a13, U18.8 (B4)
/Card5/EEPROM_SCL: J7.a18, U21.11 (B6)
/Card5/EEPROM_SDA: J7.a17, U21.9 (B5)
/Card5/SLOW_IN0: J7.c17, U22.2 (B0)
/Card5/SLOW_IN1: J7.c18, U22.3 (B1)
/Card5/SLOW_IN2: J7.c19, U22.5 (B2)
/Card5/SLOW_IN3: J7.c20, U22.6 (B3)
/Card5/SLOW_IN4: J7.c21, U22.8 (B4)
/Card5/SLOW_IN5: J7.c22, U22.9 (B5)
/Card5/SLOW_IN6: J7.c23, U22.11 (B6)
/Card5/SLOW_IN7: J7.c24, U22.12 (B7)
/Card5/SLOW_IN8: J7.c25, U22.13 (B8)
/Card5/SLOW_IN9: J7.c26, U22.14 (B9)
/Card5/SLOW_IN10: J7.c27, U22.16 (B10)
/Card5/SLOW_IN11: J7.c28, U22.17 (B11)
/Card5/SLOW_IN12: J7.c29, U22.19 (B12)
/Card5/SLOW_IN13: J7.c30, U22.20 (B13)
/Card5/SLOW_IN14: J7.c31, U22.22 (B14)
/Card5/SLOW_IN15: J7.c32, U22.23 (B15)
/Card5/SMART_IN0: J7.c1, U20.2 (B0)
/Card5/SMART_IN1: J7.c2, U20.3 (B1)
/Card5/SMART_IN2: J7.c3, U20.5 (B2)
/Card5/SMART_IN3: J7.c4, U20.6 (B3)
/Card5/SMART_IN4: J7.c5, U20.8 (B4)
/Card5/SMART_IN5: J7.c6, U20.9 (B5)
/Card5/SMART_IN6: J7.c7, U20.11 (B6)
/Card5/SMART_IN7: J7.c8, U20.12 (B7)
/Card5/SMART_IN8: J7.c9, U20.13 (B8)
/Card5/SMART_IN9: J7.c10, U20.14 (B9)
/Card5/SMART_IN10: J7.c11, U20.16 (B10)
/Card5/SMART_IN11: J7.c12, U20.17 (B11)
/Card5/SMART_IN12: J7.c13, U20.19 (B12)
/Card5/SMART_IN13: J7.c14, U20.20 (B13)
/Card5/SMART_IN14: J7.c15, U20.22 (B14)
/Card5/SMART_IN15: J7.c16, U20.23 (B15)
/Card5/SWCLK_TCK: J7.a10, U21.3 (B1)
/Card5/SWDIO_TMS: J7.a9, U21.2 (B0)
/Card5/SWO_TDO: J7.a11, U21.5 (B2)
/Card5/TDI: J7.a12, U21.6 (B3)
/Card5/USB_DM: U21.23 (B15)
/Card5/USB_DP: U21.22 (B14)
/Card5/nRESET: J7.a13, U21.8 (B4)
/Card6/EEPROM_SCL: J8.a18, U24.11 (B6)
/Card6/EEPROM_SDA: J8.a17, U24.9 (B5)
/Card6/SLOW_IN0: J8.c17, U25.2 (B0)
/Card6/SLOW_IN1: J8.c18, U25.3 (B1)
/Card6/SLOW_IN2: J8.c19, U25.5 (B2)
/Card6/SLOW_IN3: J8.c20, U25.6 (B3)
/Card6/SLOW_IN4: J8.c21, U25.8 (B4)
/Card6/SLOW_IN5: J8.c22, U25.9 (B5)
/Card6/SLOW_IN6: J8.c23, U25.11 (B6)
/Card6/SLOW_IN7: J8.c24, U25.12 (B7)
/Card6/SLOW_IN8: J8.c25, U25.13 (B8)
/Card6/SLOW_IN9: J8.c26, U25.14 (B9)
/Card6/SLOW_IN10: J8.c27, U25.16 (B10)
/Card6/SLOW_IN11: J8.c28, U25.17 (B11)
/Card6/SLOW_IN12: J8.c29, U25.19 (B12)
/Card6/SLOW_IN13: J8.c30, U25.20 (B13)
/Card6/SLOW_IN14: J8.c31, U25.22 (B14)
/Card6/SLOW_IN15: J8.c32, U25.23 (B15)
/Card6/SMART_IN0: J8.c1, U23.2 (B0)
/Card6/SMART_IN1: J8.c2, U23.3 (B1)
/Card6/SMART_IN2: J8.c3, U23.5 (B2)
/Card6/SMART_IN3: J8.c4, U23.6 (B3)
/Card6/SMART_IN4: J8.c5, U23.8 (B4)
/Card6/SMART_IN5: J8.c6, U23.9 (B5)
/Card6/SMART_IN6: J8.c7, U23.11 (B6)
/Card6/SMART_IN7: J8.c8, U23.12 (B7)
/Card6/SMART_IN8: J8.c9, U23.13 (B8)
/Card6/SMART_IN9: J8.c10, U23.14 (B9)
/Card6/SMART_IN10: J8.c11, U23.16 (B10)
/Card6/SMART_IN11: J8.c12, U23.17 (B11)
/Card6/SMART_IN12: J8.c13, U23.19 (B12)
/Card6/SMART_IN13: J8.c14, U23.20 (B13)
/Card6/SMART_IN14: J8.c15, U23.22 (B14)
/Card6/SMART_IN15: J8.c16, U23.23 (B15)
/Card6/SWCLK_TCK: J8.a10, U24.3 (B1)
/Card6/SWDIO_TMS: J8.a9, U24.2 (B0)
/Card6/SWO_TDO: J8.a11, U24.5 (B2)
/Card6/TDI: J8.a12, U24.6 (B3)
/Card6/USB_DM: U24.23 (B15)
/Card6/USB_DP: U24.22 (B14)
/Card6/nRESET: J8.a13, U24.8 (B4)
/Card7/EEPROM_SCL: J9.a18, U27.11 (B6)
/Card7/EEPROM_SDA: J9.a17, U27.9 (B5)
/Card7/SLOW_IN0: J9.c17, U28.2 (B0)
/Card7/SLOW_IN1: J9.c18, U28.3 (B1)
/Card7/SLOW_IN2: J9.c19, U28.5 (B2)
/Card7/SLOW_IN3: J9.c20, U28.6 (B3)
/Card7/SLOW_IN4: J9.c21, U28.8 (B4)
/Card7/SLOW_IN5: J9.c22, U28.9 (B5)
/Card7/SLOW_IN6: J9.c23, U28.11 (B6)
/Card7/SLOW_IN7: J9.c24, U28.12 (B7)
/Card7/SLOW_IN8: J9.c25, U28.13 (B8)
/Card7/SLOW_IN9: J9.c26, U28.14 (B9)
/Card7/SLOW_IN10: J9.c27, U28.16 (B10)
/Card7/SLOW_IN11: J9.c28, U28.17 (B11)
/Card7/SLOW_IN12: J9.c29, U28.19 (B12)
/Card7/SLOW_IN13: J9.c30, U28.20 (B13)
/Card7/SLOW_IN14: J9.c31, U28.22 (B14)
/Card7/SLOW_IN15: J9.c32, U28.23 (B15)
/Card7/SMART_IN0: J9.c1, U26.2 (B0)
/Card7/SMART_IN1: J9.c2, U26.3 (B1)
/Card7/SMART_IN2: J9.c3, U26.5 (B2)
/Card7/SMART_IN3: J9.c4, U26.6 (B3)
/Card7/SMART_IN4: J9.c5, U26.8 (B4)
/Card7/SMART_IN5: J9.c6, U26.9 (B5)
/Card7/SMART_IN6: J9.c7, U26.11 (B6)
/Card7/SMART_IN7: J9.c8, U26.12 (B7)
/Card7/SMART_IN8: J9.c9, U26.13 (B8)
/Card7/SMART_IN9: J9.c10, U26.14 (B9)
/Card7/SMART_IN10: J9.c11, U26.16 (B10)
/Card7/SMART_IN11: J9.c12, U26.17 (B11)
/Card7/SMART_IN12: J9.c13, U26.19 (B12)
/Card7/SMART_IN13: J9.c14, U26.20 (B13)
/Card7/SMART_IN14: J9.c15, U26.22 (B14)
/Card7/SMART_IN15: J9.c16, U26.23 (B15)
/Card7/SWCLK_TCK: J9.a10, U27.3 (B1)
/Card7/SWDIO_TMS: J9.a9, U27.2 (B0)
/Card7/SWO_TDO: J9.a11, U27.5 (B2)
/Card7/TDI: J9.a12, U27.6 (B3)
/Card7/USB_DM: U27.23 (B15)
/Card7/USB_DP: U27.22 (B14)
/Card7/nRESET: J9.a13, U27.8 (B4)
/USB1.D+: J3.a32; also elsewhere on the board
/USB1.D-: J3.a31; also elsewhere on the board
/USB2.D+: J4.a32; also elsewhere on the board
/USB2.D-: J4.a31; also elsewhere on the board
/USB3.D+: J5.a32; also elsewhere on the board
/USB3.D-: J5.a31; also elsewhere on the board
/USB4.D+: J6.a32; also elsewhere on the board
/USB4.D-: J6.a31; also elsewhere on the board
/USB5.D+: J7.a32; also elsewhere on the board
/USB5.D-: J7.a31; also elsewhere on the board
/USB6.D+: J8.a32; also elsewhere on the board
/USB6.D-: J8.a31; also elsewhere on the board
/USB7.D+: J9.a32; also elsewhere on the board
/USB7.D-: J9.a31; also elsewhere on the board
/nCARD1: J3.a1, R10.2, U5.25 (~OE2), U5.48 (~OE1), U6.25 (~OE2), U6.48 (~OE1), U7.25 (~OE2), U7.48 (~OE1); also elsewhere on the board
/nCARD2: J4.a1, R11.2, U11.25 (~OE2), U11.48 (~OE1), U12.25 (~OE2), U12.48 (~OE1), U13.25 (~OE2), U13.48 (~OE1); also elsewhere on the board
/nCARD3: J5.a1, R12.2, U14.25 (~OE2), U14.48 (~OE1), U15.25 (~OE2), U15.48 (~OE1), U16.25 (~OE2), U16.48 (~OE1); also elsewhere on the board
/nCARD4: J6.a1, R13.2, U17.25 (~OE2), U17.48 (~OE1), U18.25 (~OE2), U18.48 (~OE1), U19.25 (~OE2), U19.48 (~OE1); also elsewhere on the board
/nCARD5: J7.a1, R14.2, U20.25 (~OE2), U20.48 (~OE1), U21.25 (~OE2), U21.48 (~OE1), U22.25 (~OE2), U22.48 (~OE1); also elsewhere on the board
/nCARD6: J8.a1, R15.2, U23.25 (~OE2), U23.48 (~OE1), U24.25 (~OE2), U24.48 (~OE1), U25.25 (~OE2), U25.48 (~OE1); also elsewhere on the board
/nCARD7: J9.a1, R16.2, U26.25 (~OE2), U26.48 (~OE1), U27.25 (~OE2), U27.48 (~OE1), U28.25 (~OE2), U28.48 (~OE1); also elsewhere on the board
GND: C16.2, C17.2, C18.2, C19.2, C20.2, C21.2, C22.2, C23.2, C24.2, C25.2, C26.2, C27.2, C28.2, C29.2, C30.2, C31.2, C32.2, C33.2, C34.2, C35.2, C36.2, C37.2, C38.2, C39.2, C40.2, C41.2, C42.2, C43.2, C44.2, C45.2, C46.2, C47.2, C48.2, C49.2, C50.2, C51.2, C52.2, C53.2, C54.2, C55.2, C56.2, C57.2, C58.2, C59.2, C60.2, C61.2, C62.2, C63.2, C64.2, C65.2, C66.2, C67.2, C68.2, C69.2, C70.2, C71.2, C72.2, C73.2, C74.2, C75.2, C76.2, C77.2, C78.2, C79.2, C80.2, C81.2, C82.2, C83.2, C84.2, C85.2, C86.2, C87.2, C88.2, C89.2, C90.2, C91.2, C92.2, J3.a8, J3.a16, J3.a24, J3.a30, J4.a8, J4.a16, J4.a24, J4.a30, J5.a8, J5.a16, J5.a24, J5.a30, J6.a8, J6.a16, J6.a24, J6.a30, J7.a8, J7.a16, J7.a24, J7.a30, J8.a8, J8.a16, J8.a24, J8.a30, J9.a8, J9.a16, J9.a24, J9.a30, U5.4 (GND), U5.10 (GND), U5.15 (GND), U5.21 (GND), U5.28 (GND), U5.34 (GND), U5.39 (GND), U5.45 (GND), U6.4 (GND), U6.10 (GND), U6.15 (GND), U6.21 (GND), U6.28 (GND), U6.34 (GND), U6.39 (GND), U6.45 (GND), U7.4 (GND), U7.10 (GND), U7.15 (GND), U7.21 (GND), U7.28 (GND), U7.34 (GND), U7.39 (GND), U7.45 (GND), U11.4 (GND), U11.10 (GND), U11.15 (GND), U11.21 (GND), U11.28 (GND), U11.34 (GND), U11.39 (GND), U11.45 (GND), U12.4 (GND), U12.10 (GND), U12.15 (GND), U12.21 (GND), U12.28 (GND), U12.34 (GND), U12.39 (GND), U12.45 (GND), U13.4 (GND), U13.10 (GND), U13.15 (GND), U13.21 (GND), U13.28 (GND), U13.34 (GND), U13.39 (GND), U13.45 (GND), U14.4 (GND), U14.10 (GND), U14.15 (GND), U14.21 (GND), U14.28 (GND), U14.34 (GND), U14.39 (GND), U14.45 (GND), U15.4 (GND), U15.10 (GND), U15.15 (GND), U15.21 (GND), U15.28 (GND), U15.34 (GND), U15.39 (GND), U15.45 (GND), U16.4 (GND), U16.10 (GND), U16.15 (GND), U16.21 (GND), U16.28 (GND), U16.34 (GND), U16.39 (GND), U16.45 (GND), U17.4 (GND), U17.10 (GND), U17.15 (GND), U17.21 (GND), U17.28 (GND), U17.34 (GND), U17.39 (GND), U17.45 (GND), U18.4 (GND), U18.10 (GND), U18.15 (GND), U18.21 (GND), U18.28 (GND), U18.34 (GND), U18.39 (GND), U18.45 (GND), U19.4 (GND), U19.10 (GND), U19.15 (GND), U19.21 (GND), U19.28 (GND), U19.34 (GND), U19.39 (GND), U19.45 (GND), U20.4 (GND), U20.10 (GND), U20.15 (GND), U20.21 (GND), U20.28 (GND), U20.34 (GND), U20.39 (GND), U20.45 (GND), U21.4 (GND), U21.10 (GND), U21.15 (GND), U21.21 (GND), U21.28 (GND), U21.34 (GND), U21.39 (GND), U21.45 (GND), U22.4 (GND), U22.10 (GND), U22.15 (GND), U22.21 (GND), U22.28 (GND), U22.34 (GND), U22.39 (GND), U22.45 (GND), U23.4 (GND), U23.10 (GND), U23.15 (GND), U23.21 (GND), U23.28 (GND), U23.34 (GND), U23.39 (GND), U23.45 (GND), U24.4 (GND), U24.10 (GND), U24.15 (GND), U24.21 (GND), U24.28 (GND), U24.34 (GND), U24.39 (GND), U24.45 (GND), U25.4 (GND), U25.10 (GND), U25.15 (GND), U25.21 (GND), U25.28 (GND), U25.34 (GND), U25.39 (GND), U25.45 (GND), U26.4 (GND), U26.10 (GND), U26.15 (GND), U26.21 (GND), U26.28 (GND), U26.34 (GND), U26.39 (GND), U26.45 (GND), U27.4 (GND), U27.10 (GND), U27.15 (GND), U27.21 (GND), U27.28 (GND), U27.34 (GND), U27.39 (GND), U27.45 (GND), U28.4 (GND), U28.10 (GND), U28.15 (GND), U28.21 (GND), U28.28 (GND), U28.34 (GND), U28.39 (GND), U28.45 (GND); also elsewhere on the board
