ZigEmbeddedGroup/gauntlet/kicad/boards/backplane_42hp_v1/backplane_v1.kicad_pcb

## KiCad design kicad/boards/backplane_42hp_v1/backplane_v1.kicad_pcb (continued)

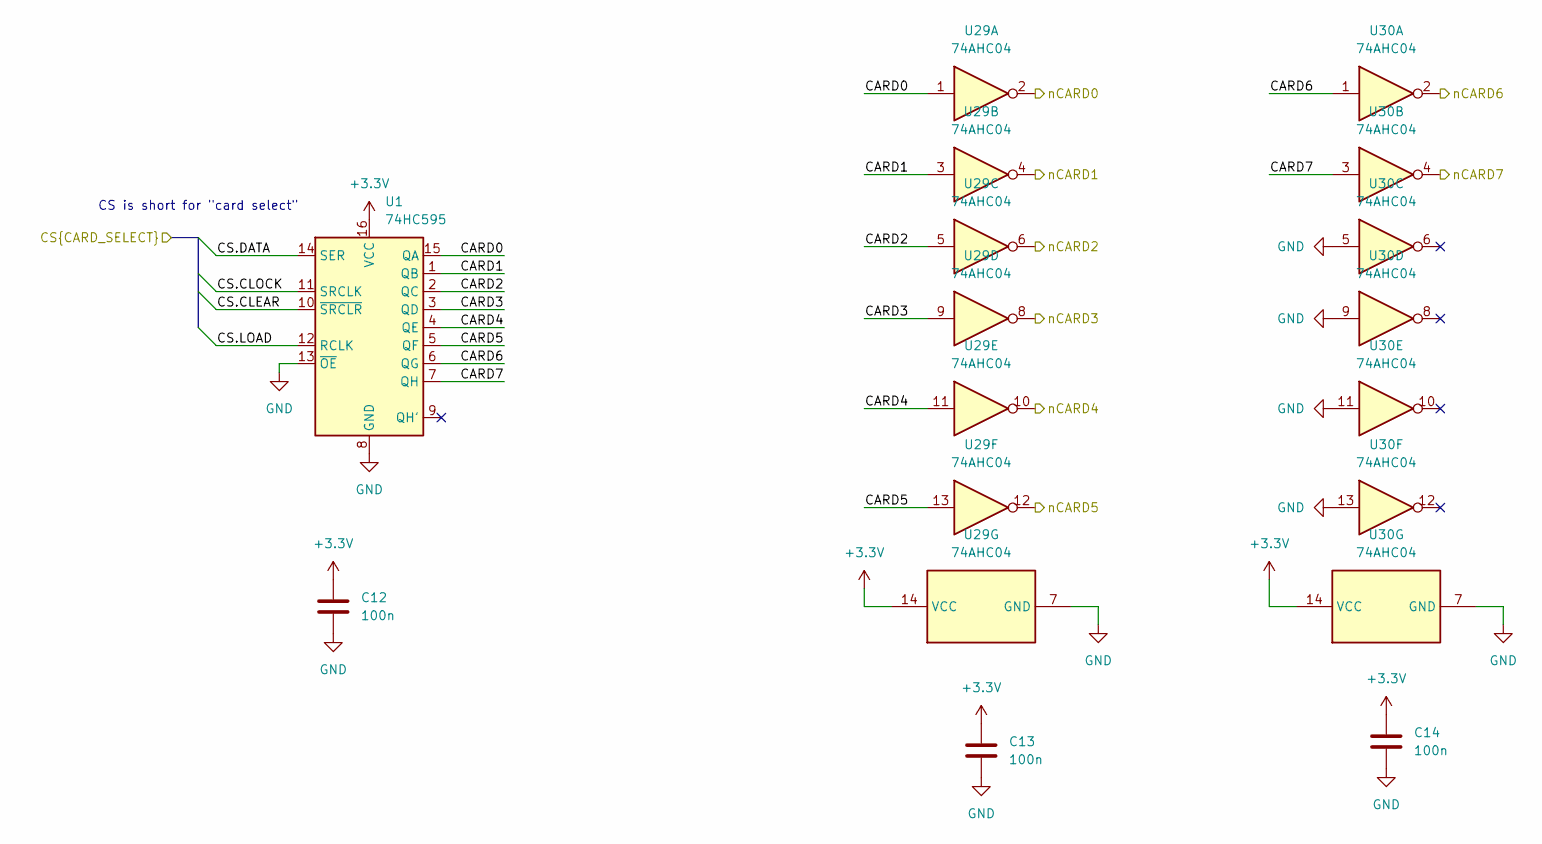
[picture p3: schematic card_select.kicad_sch]

Parts:
C12, C13, C14: 100n; C_0805_2012Metric
U1: 74HC595; TSSOP-16_4.4x5mm_P0.65mm; LCSC C5948
U29, U30: 74AHC04; TSSOP-14_4.4x5mm_P0.65mm; LCSC C415550

Connections:
+3.3V: C12.1, C13.1, C14.1, U1.16 (VCC), U29.14 (VCC), U30.14 (VCC); also elsewhere on the board
/CS.CLEAR: U1.10 (~SRCLR); also elsewhere on the board
/CS.CLOCK: U1.11 (SRCLK); also elsewhere on the board
/CS.DATA: U1.14 (SER); also elsewhere on the board
/CS.LOAD: U1.12 (RCLK); also elsewhere on the board
/Card Select/CARD0: U1.15 (QA), U29.1
/Card Select/CARD1: U1.1 (QB), U29.3
/Card Select/CARD2: U1.2 (QC), U29.5
/Card Select/CARD3: U1.3 (QD), U29.9
/Card Select/CARD4: U1.4 (QE), U29.11
/Card Select/CARD5: U1.5 (QF), U29.13
/Card Select/CARD6: U1.6 (QG), U30.1
/Card Select/CARD7: U1.7 (QH), U30.3
/nCARD0: U29.2; also elsewhere on the board
/nCARD1: U29.4; also elsewhere on the board
/nCARD2: U29.6; also elsewhere on the board
/nCARD3: U29.8; also elsewhere on the board
/nCARD4: U29.10; also elsewhere on the board
/nCARD5: U29.12; also elsewhere on the board
/nCARD6: U30.2; also elsewhere on the board
/nCARD7: U30.4; also elsewhere on the board
GND: C12.2, C13.2, C14.2, U1.8 (GND), U1.13 (~OE), U29.7 (GND), U30.5, U30.7 (GND), U30.9, U30.11, U30.13; also elsewhere on the board

Notes on the sheet:
CS is short for "card select"

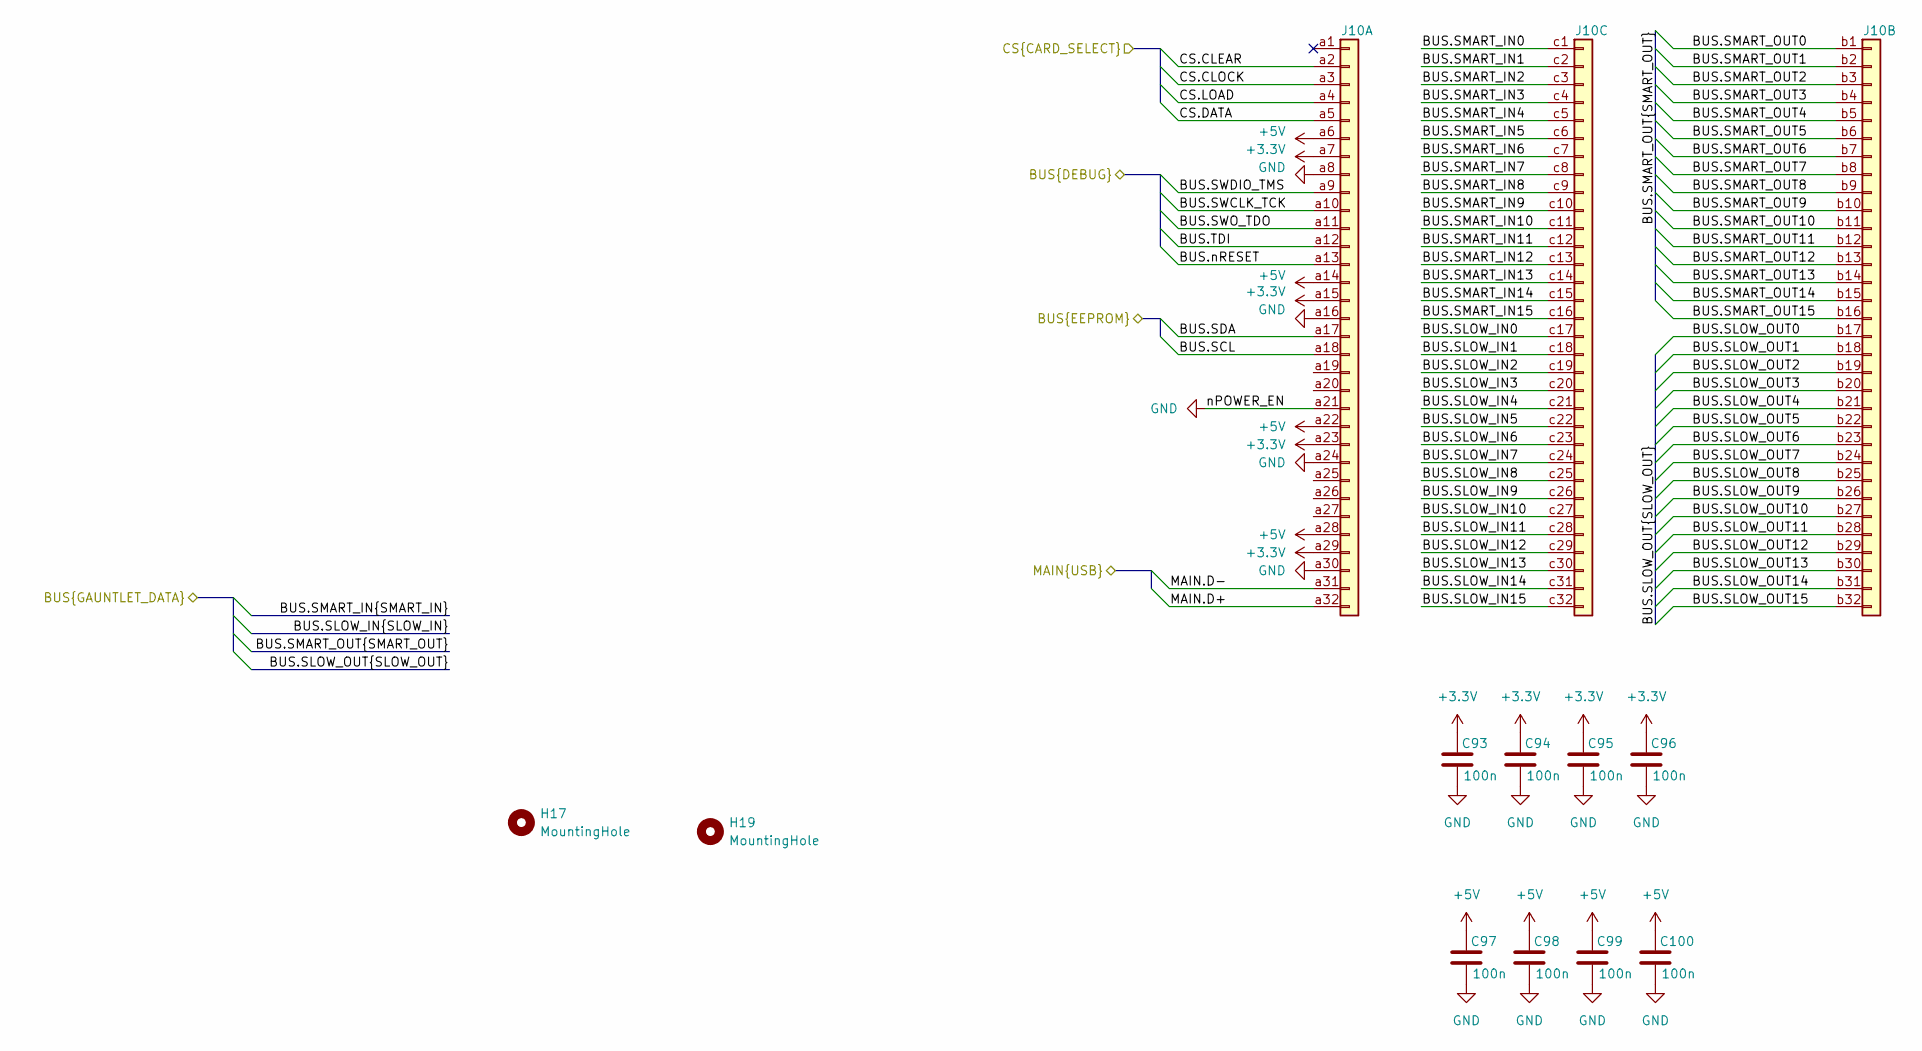
[picture p4: schematic main.kicad_sch]

Parts:
C93, C94, C95, C96, C97, C98, C99, C100: 100n; C_0603_1608Metric
H17, H19: MountingHole; MountingHole_3.2mm_M3
J10: DIN41612_03x32_C_Split; DIN41612_C_3x32_Female_Vertical_THT

Connections:
+3.3V: C93.1, C94.1, C95.1, C96.1, J10.a7, J10.a15, J10.a23, J10.a29; also elsewhere on the board
+5V: C97.1, C98.1, C99.1, C100.1, J10.a6, J10.a14, J10.a22, J10.a28; also elsewhere on the board
/BUS.SCL: J10.a18; also elsewhere on the board
/BUS.SDA: J10.a17; also elsewhere on the board
/BUS.SLOW_IN0: J10.c17; also elsewhere on the board
/BUS.SLOW_IN1: J10.c18; also elsewhere on the board
/BUS.SLOW_IN2: J10.c19; also elsewhere on the board
/BUS.SLOW_IN3: J10.c20; also elsewhere on the board
/BUS.SLOW_IN4: J10.c21; also elsewhere on the board
/BUS.SLOW_IN5: J10.c22; also elsewhere on the board
/BUS.SLOW_IN6: J10.c23; also elsewhere on the board
/BUS.SLOW_IN7: J10.c24; also elsewhere on the board
/BUS.SLOW_IN8: J10.c25; also elsewhere on the board
/BUS.SLOW_IN9: J10.c26; also elsewhere on the board
/BUS.SLOW_IN10: J10.c27; also elsewhere on the board
/BUS.SLOW_IN11: J10.c28; also elsewhere on the board
/BUS.SLOW_IN12: J10.c29; also elsewhere on the board
/BUS.SLOW_IN13: J10.c30; also elsewhere on the board
/BUS.SLOW_IN14: J10.c31; also elsewhere on the board
/BUS.SLOW_IN15: J10.c32; also elsewhere on the board
/BUS.SLOW_OUT0: J10.b17; also elsewhere on the board
/BUS.SLOW_OUT1: J10.b18; also elsewhere on the board
/BUS.SLOW_OUT2: J10.b19; also elsewhere on the board
/BUS.SLOW_OUT3: J10.b20; also elsewhere on the board
/BUS.SLOW_OUT4: J10.b21; also elsewhere on the board
/BUS.SLOW_OUT5: J10.b22; also elsewhere on the board
/BUS.SLOW_OUT6: J10.b23; also elsewhere on the board
/BUS.SLOW_OUT7: J10.b24; also elsewhere on the board
/BUS.SLOW_OUT8: J10.b25; also elsewhere on the board
/BUS.SLOW_OUT9: J10.b26; also elsewhere on the board
/BUS.SLOW_OUT10: J10.b27; also elsewhere on the board
/BUS.SLOW_OUT11: J10.b28; also elsewhere on the board
/BUS.SLOW_OUT12: J10.b29; also elsewhere on the board
/BUS.SLOW_OUT13: J10.b30; also elsewhere on the board
/BUS.SLOW_OUT14: J10.b31; also elsewhere on the board
/BUS.SLOW_OUT15: J10.b32; also elsewhere on the board
/BUS.SMART_IN0: J10.c1; also elsewhere on the board
/BUS.SMART_IN1: J10.c2; also elsewhere on the board
/BUS.SMART_IN2: J10.c3; also elsewhere on the board
/BUS.SMART_IN3: J10.c4; also elsewhere on the board
/BUS.SMART_IN4: J10.c5; also elsewhere on the board
/BUS.SMART_IN5: J10.c6; also elsewhere on the board
/BUS.SMART_IN6: J10.c7; also elsewhere on the board
/BUS.SMART_IN7: J10.c8; also elsewhere on the board
/BUS.SMART_IN8: J10.c9; also elsewhere on the board
/BUS.SMART_IN9: J10.c10; also elsewhere on the board
/BUS.SMART_IN10: J10.c11; also elsewhere on the board
/BUS.SMART_IN11: J10.c12; also elsewhere on the board
/BUS.SMART_IN12: J10.c13; also elsewhere on the board
/BUS.SMART_IN13: J10.c14; also elsewhere on the board
/BUS.SMART_IN14: J10.c15; also elsewhere on the board
/BUS.SMART_IN15: J10.c16; also elsewhere on the board
/BUS.SMART_OUT0: J10.b1; also elsewhere on the board
/BUS.SMART_OUT1: J10.b2; also elsewhere on the board
/BUS.SMART_OUT2: J10.b3; also elsewhere on the board
/BUS.SMART_OUT3: J10.b4; also elsewhere on the board
/BUS.SMART_OUT4: J10.b5; also elsewhere on the board
/BUS.SMART_OUT5: J10.b6; also elsewhere on the board
/BUS.SMART_OUT6: J10.b7; also elsewhere on the board
/BUS.SMART_OUT7: J10.b8; also elsewhere on the board
/BUS.SMART_OUT8: J10.b9; also elsewhere on the board
/BUS.SMART_OUT9: J10.b10; also elsewhere on the board
/BUS.SMART_OUT10: J10.b11; also elsewhere on the board
/BUS.SMART_OUT11: J10.b12; also elsewhere on the board
/BUS.SMART_OUT12: J10.b13; also elsewhere on the board
/BUS.SMART_OUT13: J10.b14; also elsewhere on the board
/BUS.SMART_OUT14: J10.b15; also elsewhere on the board
/BUS.SMART_OUT15: J10.b16; also elsewhere on the board
/BUS.SWCLK_TCK: J10.a10; also elsewhere on the board
/BUS.SWDIO_TMS: J10.a9; also elsewhere on the board
/BUS.SWO_TDO: J10.a11; also elsewhere on the board
/BUS.TDI: J10.a12; also elsewhere on the board
/BUS.nRESET: J10.a13; also elsewhere on the board
/CS.CLEAR: J10.a2; also elsewhere on the board
/CS.CLOCK: J10.a3; also elsewhere on the board
/CS.DATA: J10.a5; also elsewhere on the board
/CS.LOAD: J10.a4; also elsewhere on the board
/MAIN.D+: J10.a32; also elsewhere on the board
/MAIN.D-: J10.a31; also elsewhere on the board
GND: C93.2, C94.2, C95.2, C96.2, C97.2, C98.2, C99.2, C100.2, J10.a8, J10.a16, J10.a21, J10.a24, J10.a30; also elsewhere on the board

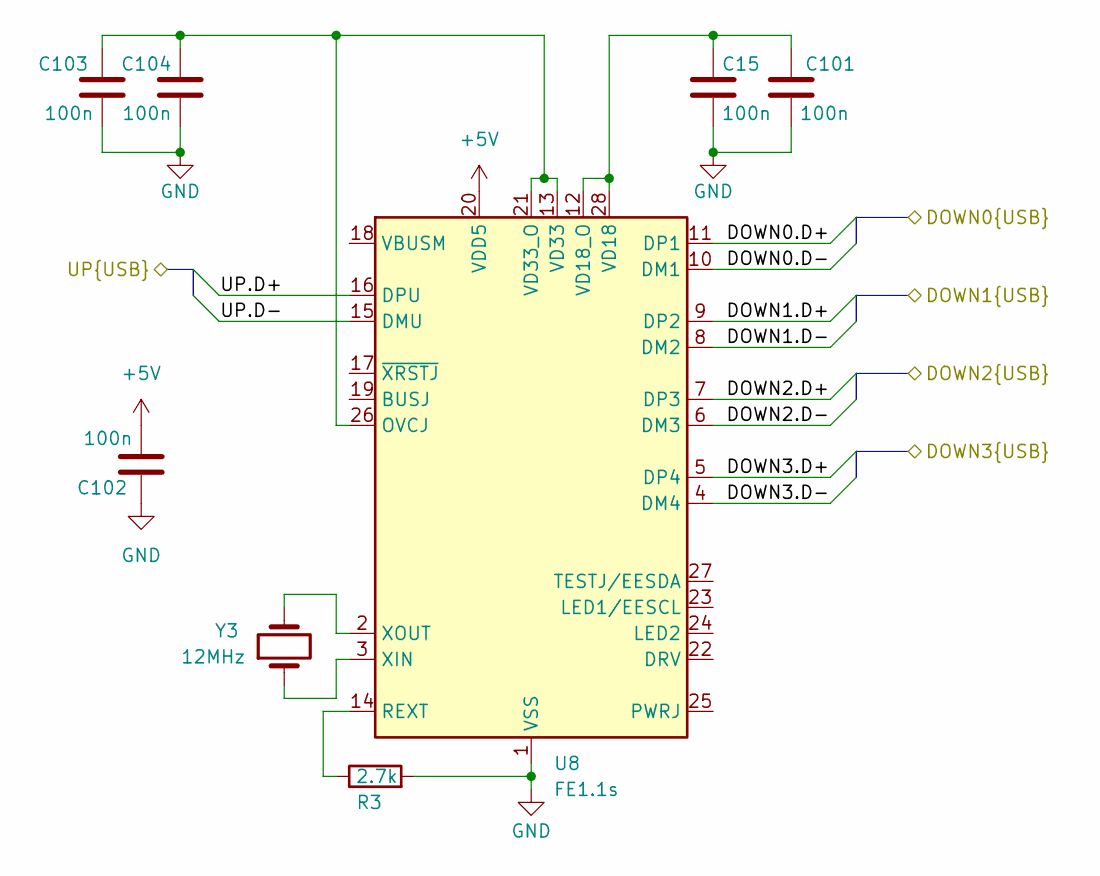
[picture p5: schematic usb_hub.kicad_sch]

Parts:
C15, C101, C102, C103, C104: 100n
R3: 2.7k
U8: FE1.1s; SSOP-28_3.9x9.9mm_P0.635mm
Y3: 12MHz

Connections:
+5V: C102.1, U8.20 (VDD5); also elsewhere on the board
/MAIN.D+: U8.16 (DPU); also elsewhere on the board
/MAIN.D-: U8.15 (DMU); also elsewhere on the board
/USB Hubs/USB Hub/DOWN0.D+: U8.11 (DP1); also elsewhere on the board
/USB Hubs/USB Hub/DOWN0.D-: U8.10 (DM1); also elsewhere on the board
/USB Hubs/USB Hub/DOWN1.D+: U8.9 (DP2); also elsewhere on the board
/USB Hubs/USB Hub/DOWN1.D-: U8.8 (DM2); also elsewhere on the board
/USB Hubs/USB Hub/DOWN2.D+: U8.7 (DP3)
/USB Hubs/USB Hub/DOWN2.D-: U8.6 (DM3)
/USB Hubs/USB Hub/DOWN3.D+: U8.5 (DP4)
/USB Hubs/USB Hub/DOWN3.D-: U8.4 (DM4)
GND: C15.1, C101.1, C102.2, C103.1, C104.1, R3.2, U8.1 (VSS); also elsewhere on the board
unnamed: U8.13 (VD33), U8.21 (VD33_O), U8.26 (OVCJ)
unnamed: U8.12 (VD18_O), U8.28 (VD18)

Parts of its further copies:
U9, U10: FE1.1s; SSOP-28_3.9x9.9mm_P0.635mm

Connections of its further copies:
+5V: U9.20 (VDD5), U10.20 (VDD5); also elsewhere on the board
/USB0.D+: U9.5 (DP4); also elsewhere on the board
/USB0.D-: U9.4 (DM4); also elsewhere on the board
/USB1.D+: U9.7 (DP3); also elsewhere on the board
/USB1.D-: U9.6 (DM3); also elsewhere on the board
/USB2.D+: U9.9 (DP2); also elsewhere on the board
/USB2.D-: U9.8 (DM2); also elsewhere on the board
/USB3.D+: U9.11 (DP1); also elsewhere on the board
/USB3.D-: U9.10 (DM1); also elsewhere on the board
/USB4.D+: U10.5 (DP4); also elsewhere on the board
/USB4.D-: U10.4 (DM4); also elsewhere on the board
/USB5.D+: U10.7 (DP3); also elsewhere on the board
/USB5.D-: U10.6 (DM3); also elsewhere on the board
/USB6.D+: U10.9 (DP2); also elsewhere on the board
/USB6.D-: U10.8 (DM2); also elsewhere on the board
/USB7.D+: U10.11 (DP1); also elsewhere on the board
/USB7.D-: U10.10 (DM1); also elsewhere on the board
/USB Hubs/USB Hub/DOWN0.D+: U9.16 (DPU); also elsewhere on the board
/USB Hubs/USB Hub/DOWN0.D-: U9.15 (DMU); also elsewhere on the board
/USB Hubs/USB Hub/DOWN1.D+: U10.16 (DPU); also elsewhere on the board
/USB Hubs/USB Hub/DOWN1.D-: U10.15 (DMU); also elsewhere on the board
GND: U9.1 (VSS), U10.1 (VSS); also elsewhere on the board
unnamed: U9.13 (VD33), U9.21 (VD33_O), U9.26 (OVCJ)
unnamed: U9.12 (VD18_O), U9.28 (VD18)
unnamed: U10.13 (VD33), U10.21 (VD33_O), U10.26 (OVCJ)
unnamed: U10.12 (VD18_O), U10.28 (VD18)

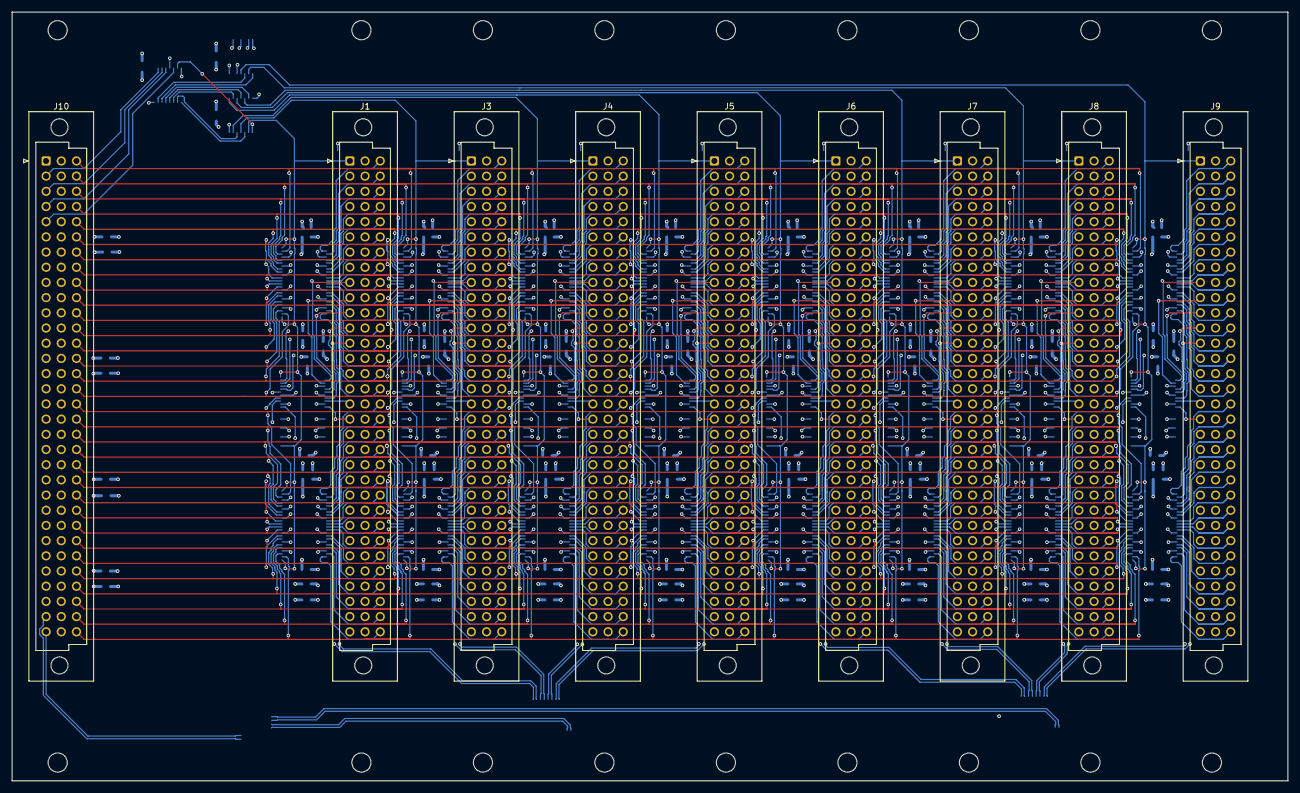
[picture p6: board backplane_v1.kicad_pcb from above]

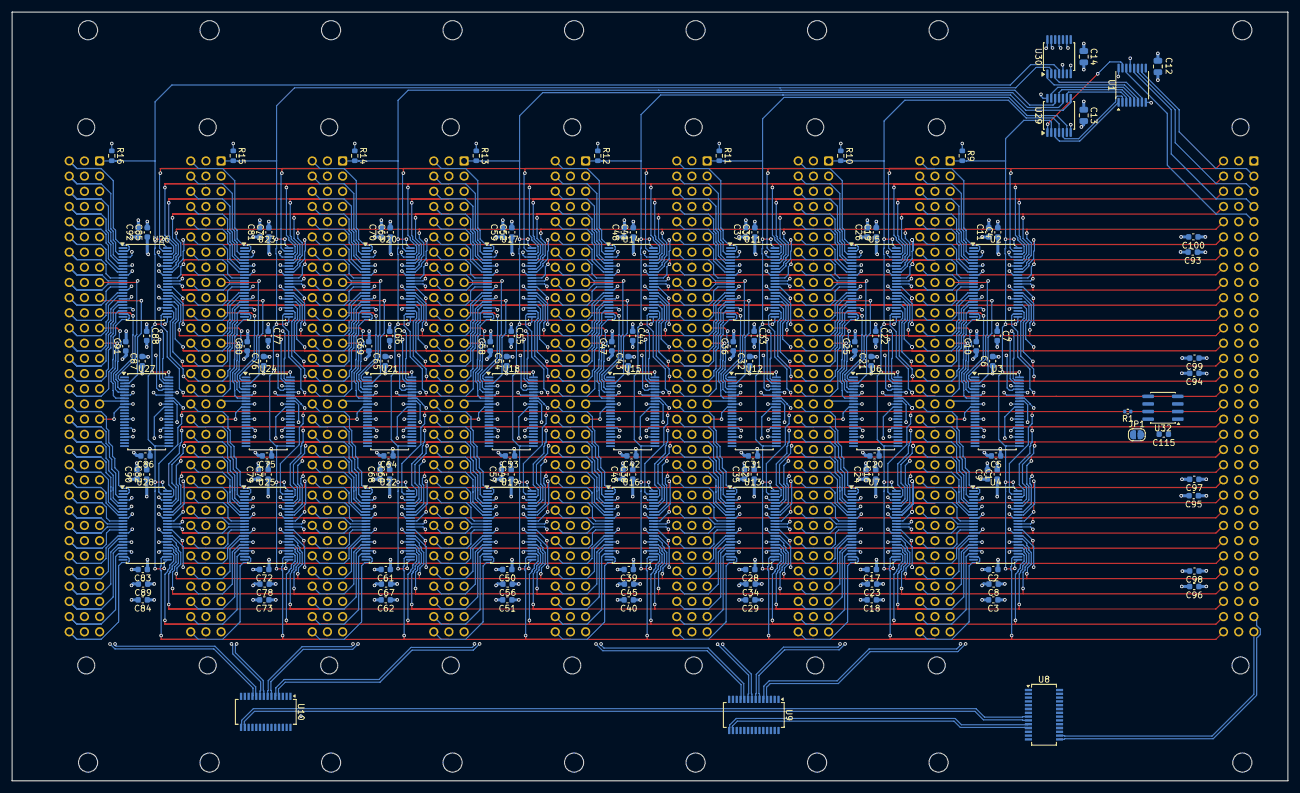
[picture p7: board backplane_v1.kicad_pcb from below]

Board: 6 copper layers, 213.4 x 128.6 mm, 168 parts (141 on the bottom side), 435 nets.
