ZigEmbeddedGroup/gauntlet/kicad/boards/breakout_card/breakout_card.kicad_pcb

## KiCad design kicad/boards/breakout_card/breakout_card.kicad_pcb (2026-10-21)

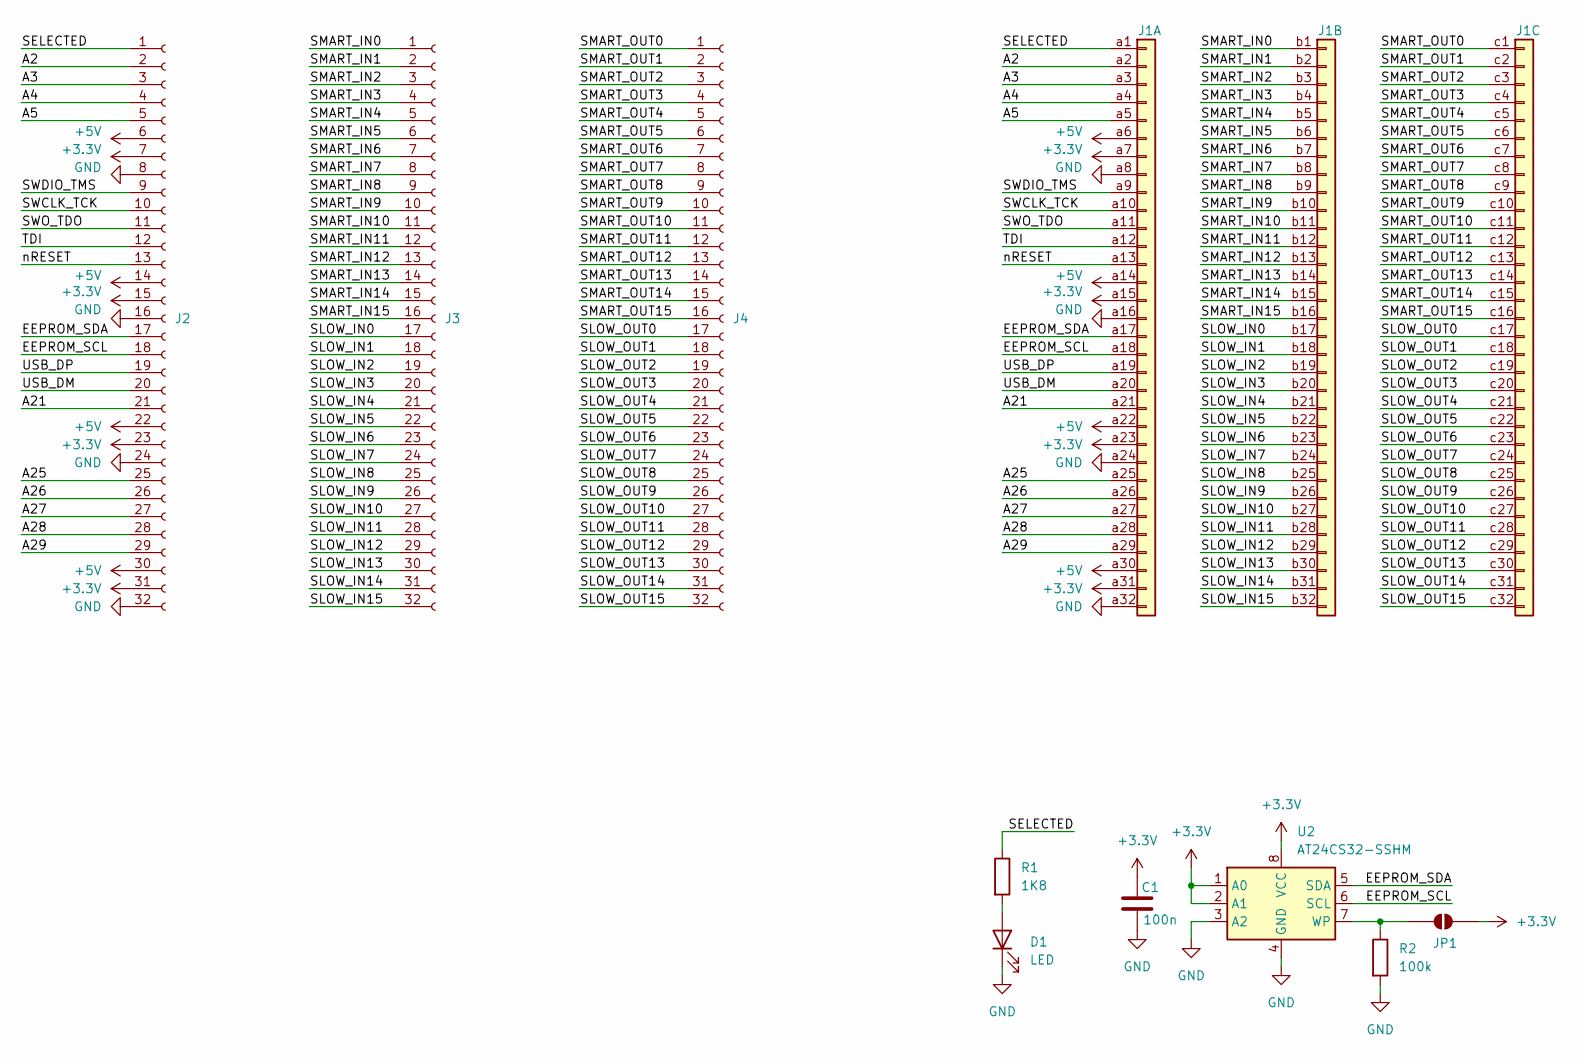
[picture p8: schematic breakout_card.kicad_sch]

Parts:
C1: 100n; C_0603_1608Metric
D1: LED; LED_Kingbright_APDA3020VBCD
J1: DIN41612_03x32_C_Split; DIN41612_C_3x32_Male_Horizontal_THT
J2, J3, J4: Conn_01x32_Socket; PinHeader_1x32_P2.54mm_Vertical
JP1: SolderJumper_2_Open; SolderJumper-2_P1.3mm_Open_RoundedPad1.0x1.5mm
R1: 1K8; R_0603_1608Metric_Pad0.98x0.95mm_HandSolder
R2: 100k; R_0603_1608Metric
U2: AT24CS32-SSHM; SOIC-8_3.9x4.9mm_P1.27mm

Connections:
+3.3V: C1.1, J1.a7, J1.a15, J1.a23, J1.a31, J2.7, J2.15, J2.23, J2.31, JP1.2 (B), U2.1 (A0), U2.2 (A1), U2.8 (VCC)
+5V: J1.a6, J1.a14, J1.a22, J1.a30, J2.6, J2.14, J2.22, J2.30
/A2: J1.a2, J2.2
/A3: J1.a3, J2.3
/A4: J1.a4, J2.4
/A5: J1.a5, J2.5
/A21: J1.a21, J2.21
/A25: J1.a25, J2.25
/A26: J1.a26, J2.26
/A27: J1.a27, J2.27
/A28: J1.a28, J2.28
/A29: J1.a29, J2.29
/EEPROM_SCL: J1.a18, J2.18, U2.6 (SCL)
/EEPROM_SDA: J1.a17, J2.17, U2.5 (SDA)
/SELECTED: J1.a1, J2.1, R1.1
/SLOW_IN0: J1.b17, J3.17
/SLOW_IN1: J1.b18, J3.18
/SLOW_IN2: J1.b19, J3.19
/SLOW_IN3: J1.b20, J3.20
/SLOW_IN4: J1.b21, J3.21
/SLOW_IN5: J1.b22, J3.22
/SLOW_IN6: J1.b23, J3.23
/SLOW_IN7: J1.b24, J3.24
/SLOW_IN8: J1.b25, J3.25
/SLOW_IN9: J1.b26, J3.26
/SLOW_IN10: J1.b27, J3.27
/SLOW_IN11: J1.b28, J3.28
/SLOW_IN12: J1.b29, J3.29
/SLOW_IN13: J1.b30, J3.30
/SLOW_IN14: J1.b31, J3.31
/SLOW_IN15: J1.b32, J3.32
/SLOW_OUT0: J1.c17, J4.17
/SLOW_OUT1: J1.c18, J4.18
/SLOW_OUT2: J1.c19, J4.19
/SLOW_OUT3: J1.c20, J4.20
/SLOW_OUT4: J1.c21, J4.21
/SLOW_OUT5: J1.c22, J4.22
/SLOW_OUT6: J1.c23, J4.23
/SLOW_OUT7: J1.c24, J4.24
/SLOW_OUT8: J1.c25, J4.25
/SLOW_OUT9: J1.c26, J4.26
/SLOW_OUT10: J1.c27, J4.27
/SLOW_OUT11: J1.c28, J4.28
/SLOW_OUT12: J1.c29, J4.29
/SLOW_OUT13: J1.c30, J4.30
/SLOW_OUT14: J1.c31, J4.31
/SLOW_OUT15: J1.c32, J4.32
/SMART_IN0: J1.b1, J3.1
/SMART_IN1: J1.b2, J3.2
/SMART_IN2: J1.b3, J3.3
/SMART_IN3: J1.b4, J3.4
/SMART_IN4: J1.b5, J3.5
/SMART_IN5: J1.b6, J3.6
/SMART_IN6: J1.b7, J3.7
/SMART_IN7: J1.b8, J3.8
/SMART_IN8: J1.b9, J3.9
/SMART_IN9: J1.b10, J3.10
/SMART_IN10: J1.b11, J3.11
/SMART_IN11: J1.b12, J3.12
/SMART_IN12: J1.b13, J3.13
/SMART_IN13: J1.b14, J3.14
/SMART_IN14: J1.b15, J3.15
/SMART_IN15: J1.b16, J3.16
/SMART_OUT0: J1.c1, J4.1
/SMART_OUT1: J1.c2, J4.2
/SMART_OUT2: J1.c3, J4.3
/SMART_OUT3: J1.c4, J4.4
/SMART_OUT4: J1.c5, J4.5
/SMART_OUT5: J1.c6, J4.6
/SMART_OUT6: J1.c7, J4.7
/SMART_OUT7: J1.c8, J4.8
/SMART_OUT8: J1.c9, J4.9
/SMART_OUT9: J1.c10, J4.10
/SMART_OUT10: J1.c11, J4.11
/SMART_OUT11: J1.c12, J4.12
/SMART_OUT12: J1.c13, J4.13
/SMART_OUT13: J1.c14, J4.14
/SMART_OUT14: J1.c15, J4.15
/SMART_OUT15: J1.c16, J4.16
/SWCLK_TCK: J1.a10, J2.10
/SWDIO_TMS: J1.a9, J2.9
/SWO_TDO: J1.a11, J2.11
/TDI: J1.a12, J2.12
/USB_DM: J1.a20, J2.20
/USB_DP: J1.a19, J2.19
/nRESET: J1.a13, J2.13
GND: C1.2, D1.1 (K), J1.a8, J1.a16, J1.a24, J1.a32, J2.8, J2.16, J2.24, J2.32, R2.2, U2.3 (A2), U2.4 (GND)
unnamed: D1.2 (A), R1.2
unnamed: JP1.1 (A), R2.1, U2.7 (WP)

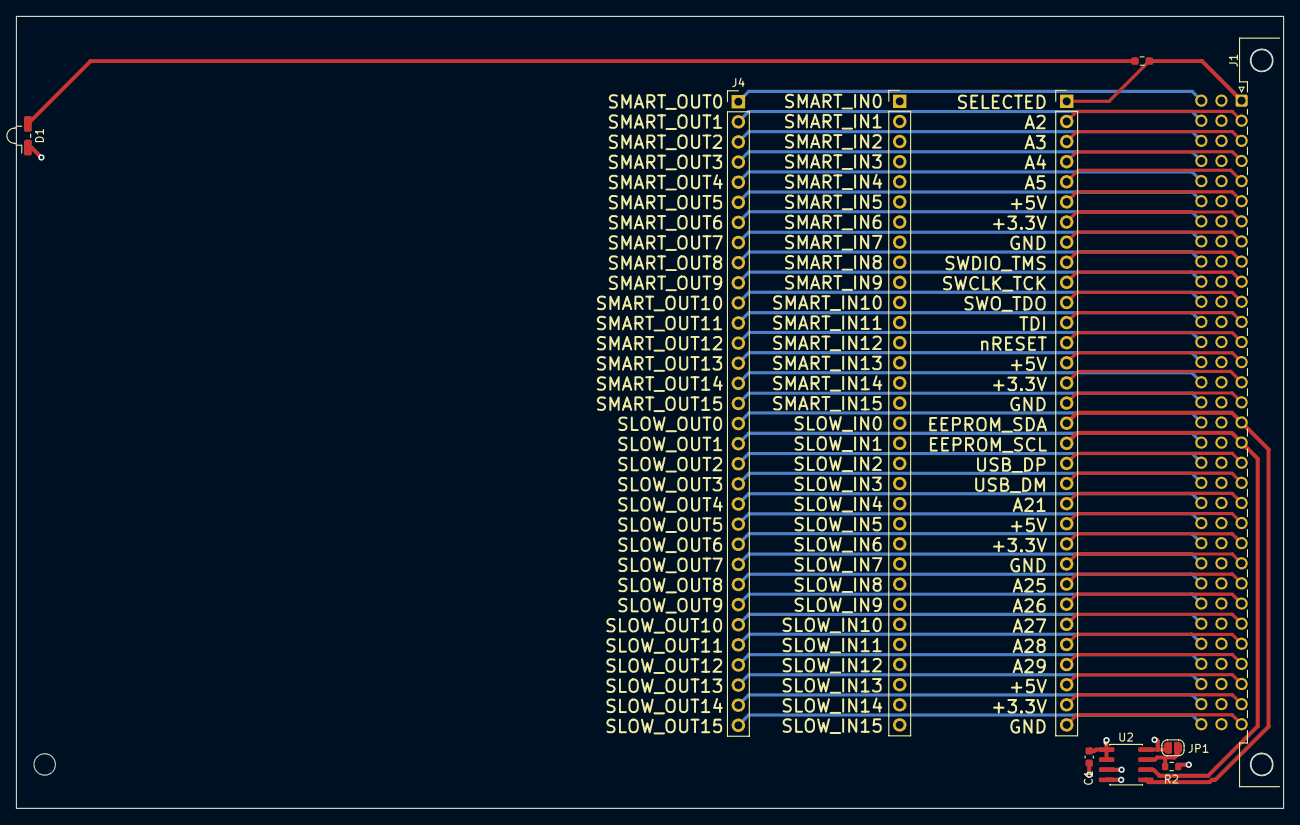
[picture p9: board breakout_card.kicad_pcb from above]

Board: 4 copper layers, 160.0 x 100.0 mm, 13 parts (0 on the bottom side), 89 nets.

Other parts of the board:
MH2, MH3, MH4: MountingHole_2.7mm_M2.5_DIN965
