ZigEmbeddedGroup/gauntlet/kicad/boards/backplane_14hp_v1/backplane_14hp_v1.kicad_pcb

## KiCad design kicad/boards/backplane_14hp_v1/backplane_14hp_v1.kicad_pcb (2026-10-21)

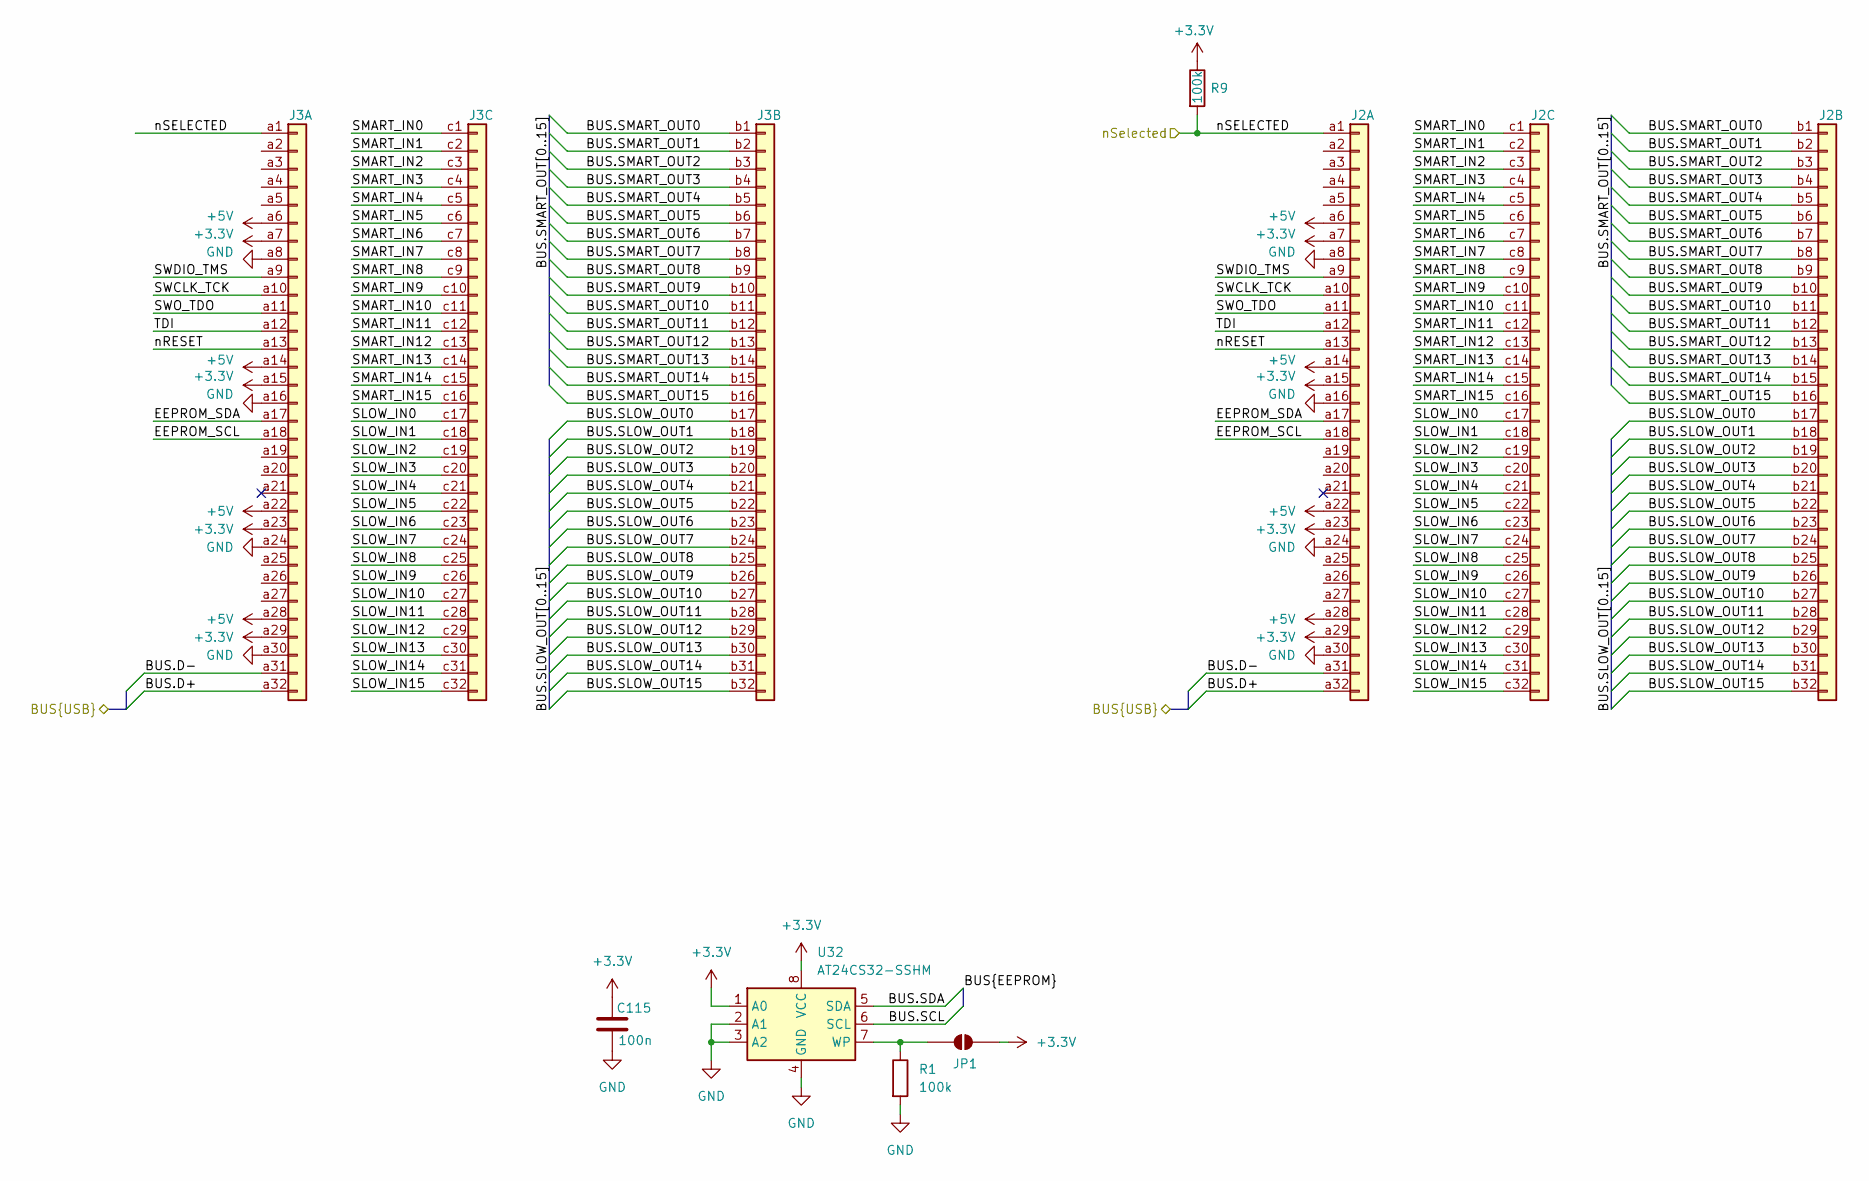
[picture p10: schematic backplane_14hp_v1.kicad_sch]

Parts:
C115: 100n; C_0603_1608Metric
J2, J3: DIN41612_03x32_C_Split; DIN41612_C_3x32_Female_Vertical_THT
JP1: SolderJumper_2_Open; SolderJumper-2_P1.3mm_Open_RoundedPad1.0x1.5mm
R1, R9: 100k; R_0603_1608Metric
U32: AT24CS32-SSHM; SOIC-8_3.9x4.9mm_P1.27mm

Connections:
+3.3V: C115.1, J2.a7, J2.a15, J2.a23, J2.a29, J3.a7, J3.a15, J3.a23, J3.a29, JP1.2 (B), R9.1, U32.1 (A0), U32.8 (VCC)
+5V: J2.a6, J2.a14, J2.a22, J2.a28, J3.a6, J3.a14, J3.a22, J3.a28
/BUS.D+: J2.a32, J3.a32
/BUS.D-: J2.a31, J3.a31
/BUS.SCL: U32.6 (SCL)
/BUS.SDA: U32.5 (SDA)
/BUS.SLOW_OUT0: J2.b17, J3.b17
/BUS.SLOW_OUT1: J2.b18, J3.b18
/BUS.SLOW_OUT2: J2.b19, J3.b19
/BUS.SLOW_OUT3: J2.b20, J3.b20
/BUS.SLOW_OUT4: J2.b21, J3.b21
/BUS.SLOW_OUT5: J2.b22, J3.b22
/BUS.SLOW_OUT6: J2.b23, J3.b23
/BUS.SLOW_OUT7: J2.b24, J3.b24
/BUS.SLOW_OUT8: J2.b25, J3.b25
/BUS.SLOW_OUT9: J2.b26, J3.b26
/BUS.SLOW_OUT10: J2.b27, J3.b27
/BUS.SLOW_OUT11: J2.b28, J3.b28
/BUS.SLOW_OUT12: J2.b29, J3.b29
/BUS.SLOW_OUT13: J2.b30, J3.b30
/BUS.SLOW_OUT14: J2.b31, J3.b31
/BUS.SLOW_OUT15: J2.b32, J3.b32
/BUS.SMART_OUT0: J2.b1, J3.b1
/BUS.SMART_OUT1: J2.b2, J3.b2
/BUS.SMART_OUT2: J2.b3, J3.b3
/BUS.SMART_OUT3: J2.b4, J3.b4
/BUS.SMART_OUT4: J2.b5, J3.b5
/BUS.SMART_OUT5: J2.b6, J3.b6
/BUS.SMART_OUT6: J2.b7, J3.b7
/BUS.SMART_OUT7: J2.b8, J3.b8
/BUS.SMART_OUT8: J2.b9, J3.b9
/BUS.SMART_OUT9: J2.b10, J3.b10
/BUS.SMART_OUT10: J2.b11, J3.b11
/BUS.SMART_OUT11: J2.b12, J3.b12
/BUS.SMART_OUT12: J2.b13, J3.b13
/BUS.SMART_OUT13: J2.b14, J3.b14
/BUS.SMART_OUT14: J2.b15, J3.b15
/BUS.SMART_OUT15: J2.b16, J3.b16
/EEPROM_SCL: J2.a18, J3.a18
/EEPROM_SDA: J2.a17, J3.a17
/SLOW_IN0: J2.c17, J3.c17
/SLOW_IN1: J2.c18, J3.c18
/SLOW_IN2: J2.c19, J3.c19
/SLOW_IN3: J2.c20, J3.c20
/SLOW_IN4: J2.c21, J3.c21
/SLOW_IN5: J2.c22, J3.c22
/SLOW_IN6: J2.c23, J3.c23
/SLOW_IN7: J2.c24, J3.c24
/SLOW_IN8: J2.c25, J3.c25
/SLOW_IN9: J2.c26, J3.c26
/SLOW_IN10: J2.c27, J3.c27
/SLOW_IN11: J2.c28, J3.c28
/SLOW_IN12: J2.c29, J3.c29
/SLOW_IN13: J2.c30, J3.c30
/SLOW_IN14: J2.c31, J3.c31
/SLOW_IN15: J2.c32, J3.c32
/SMART_IN0: J2.c1, J3.c1
/SMART_IN1: J2.c2, J3.c2
/SMART_IN2: J2.c3, J3.c3
/SMART_IN3: J2.c4, J3.c4
/SMART_IN4: J2.c5, J3.c5
/SMART_IN5: J2.c6, J3.c6
/SMART_IN6: J2.c7, J3.c7
/SMART_IN7: J2.c8, J3.c8
/SMART_IN8: J2.c9, J3.c9
/SMART_IN9: J2.c10, J3.c10
/SMART_IN10: J2.c11, J3.c11
/SMART_IN11: J2.c12, J3.c12
/SMART_IN12: J2.c13, J3.c13
/SMART_IN13: J2.c14, J3.c14
/SMART_IN14: J2.c15, J3.c15
/SMART_IN15: J2.c16, J3.c16
/SWCLK_TCK: J2.a10, J3.a10
/SWDIO_TMS: J2.a9, J3.a9
/SWO_TDO: J2.a11, J3.a11
/TDI: J2.a12, J3.a12
/nRESET: J2.a13, J3.a13
/nSELECTED: J2.a1, J3.a1, R9.2
GND: C115.2, J2.a8, J2.a16, J2.a24, J2.a30, J3.a8, J3.a16, J3.a24, J3.a30, R1.2, U32.2 (A1), U32.3 (A2), U32.4 (GND)
unnamed: JP1.1 (A), R1.1, U32.7 (WP)

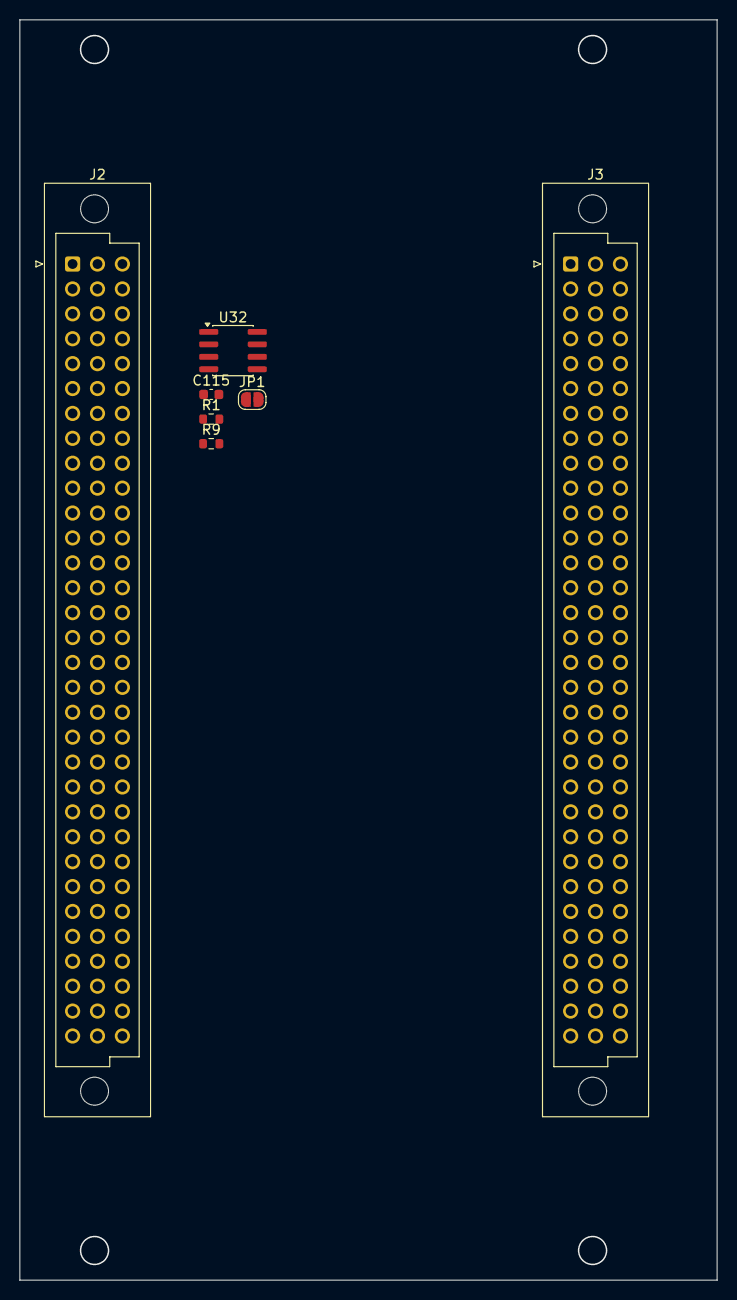
[picture p11: board backplane_14hp_v1.kicad_pcb from above]

Board: 8 copper layers, 71.1 x 128.6 mm, 7 parts (0 on the bottom side), 78 nets.
