ZigEmbeddedGroup/gauntlet/kicad/boards/test_card/test_card.kicad_pcb

## KiCad design kicad/boards/test_card/test_card.kicad_pcb (2026-10-21)

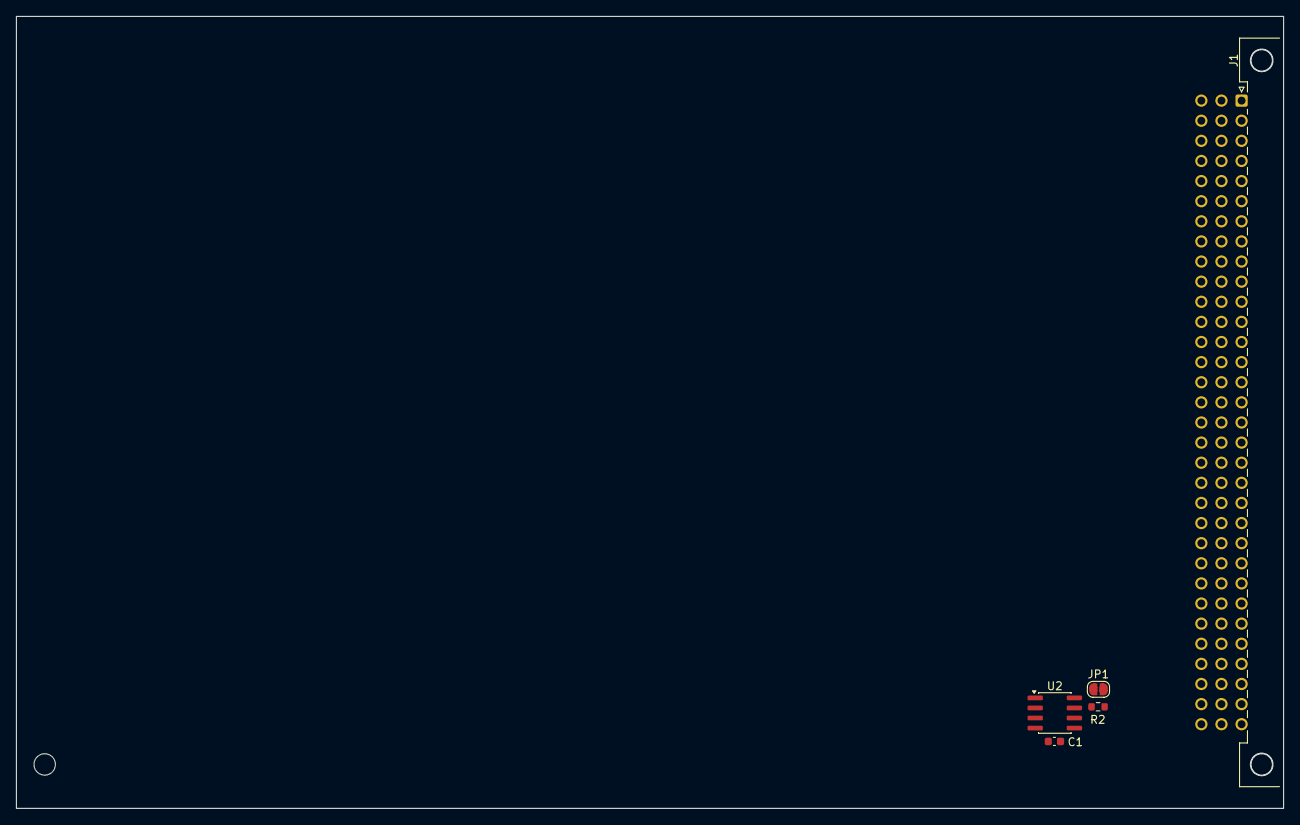
[picture p12: board test_card.kicad_pcb from above]

Board: 2 copper layers, 160.0 x 100.0 mm, 8 parts (0 on the bottom side), 4 nets, no tracks yet.

Parts:
C1: 100n; C_0603_1608Metric
J1: DIN41612_03x32_C_Split; DIN41612_C_3x32_Male_Horizontal_THT
JP1: SolderJumper_2_Open; SolderJumper-2_P1.3mm_Open_RoundedPad1.0x1.5mm
MH2, MH3, MH4: MountingHole_2.7mm_M2.5_DIN965
R2: 100k; R_0603_1608Metric
U2: AT24CS32-SSHM; SOIC-8_3.9x4.9mm_P1.27mm

Connections:
+3.3V: C1.1, J1.a7, J1.a15, J1.a23, J1.a31, JP1.2 (B), U2.1 (A0), U2.2 (A1), U2.8 (VCC)
+5V: J1.a6, J1.a14, J1.a22, J1.a30
GND: C1.2, J1.a8, J1.a16, J1.a24, J1.a32, R2.2, U2.3 (A2), U2.4 (GND)
unnamed: JP1.1 (A), R2.1, U2.7 (WP)
