ZigEmbeddedGroup/gauntlet/kicad/boards/main/main.kicad_pcb

## KiCad design kicad/boards/main/main.kicad_pcb (2026-10-21)

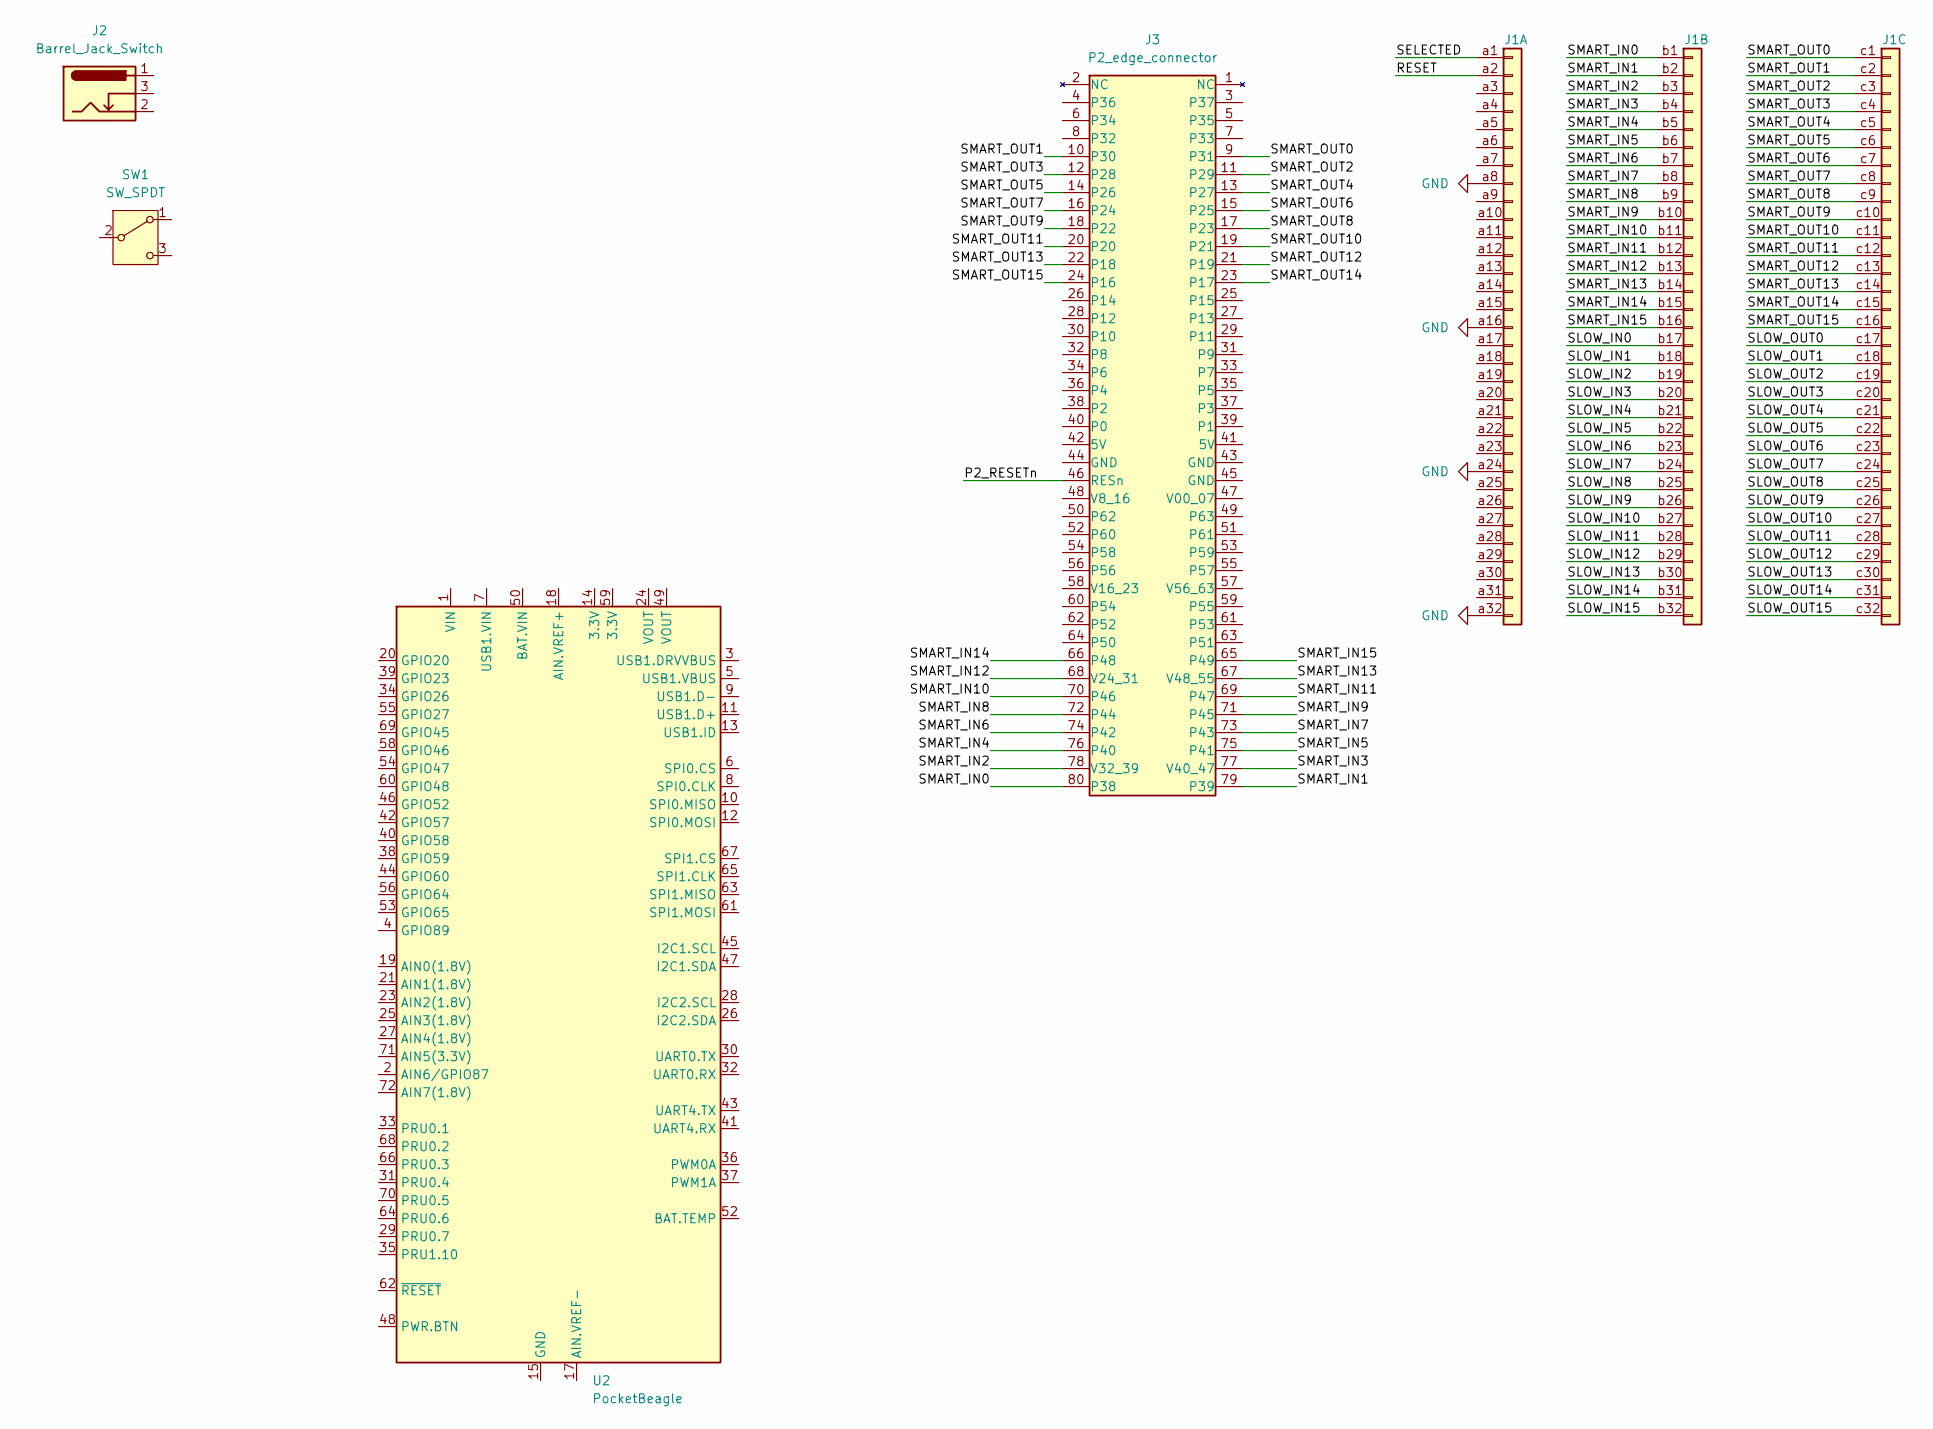
[picture p13: schematic main.kicad_sch]

Parts:
J1: DIN41612_03x32_C_Split; DIN41612_C_3x32_Male_Horizontal_THT
J2: Barrel_Jack_Switch; QFN-40-1EP_6x6mm_P0.5mm_EP4.6x4.6mm
J3: P2_edge_connector; 4UCON_10156_2x40_P1.27mm_Socket_Horizontal
SW1: SW_SPDT; SW_NKK_GW12LJP
U2: PocketBeagle; BeagleBoard_PocketBeagle

Connections:
/P2_RESETn: J3.46 (RESn)
/RESET: J1.a2
/SELECTED: J1.a1
/SLOW_IN0: J1.b17
/SLOW_IN1: J1.b18
/SLOW_IN2: J1.b19
/SLOW_IN3: J1.b20
/SLOW_IN4: J1.b21
/SLOW_IN5: J1.b22
/SLOW_IN6: J1.b23
/SLOW_IN7: J1.b24
/SLOW_IN8: J1.b25
/SLOW_IN9: J1.b26
/SLOW_IN10: J1.b27
/SLOW_IN11: J1.b28
/SLOW_IN12: J1.b29
/SLOW_IN13: J1.b30
/SLOW_IN14: J1.b31
/SLOW_IN15: J1.b32
/SLOW_OUT0: J1.c17
/SLOW_OUT1: J1.c18
/SLOW_OUT2: J1.c19
/SLOW_OUT3: J1.c20
/SLOW_OUT4: J1.c21
/SLOW_OUT5: J1.c22
/SLOW_OUT6: J1.c23
/SLOW_OUT7: J1.c24
/SLOW_OUT8: J1.c25
/SLOW_OUT9: J1.c26
/SLOW_OUT10: J1.c27
/SLOW_OUT11: J1.c28
/SLOW_OUT12: J1.c29
/SLOW_OUT13: J1.c30
/SLOW_OUT14: J1.c31
/SLOW_OUT15: J1.c32
/SMART_IN0: J1.b1, J3.80 (P38)
/SMART_IN1: J1.b2, J3.79 (P39)
/SMART_IN2: J1.b3, J3.78 (V32_39)
/SMART_IN3: J1.b4, J3.77 (V40_47)
/SMART_IN4: J1.b5, J3.76 (P40)
/SMART_IN5: J1.b6, J3.75 (P41)
/SMART_IN6: J1.b7, J3.74 (P42)
/SMART_IN7: J1.b8, J3.73 (P43)
/SMART_IN8: J1.b9, J3.72 (P44)
/SMART_IN9: J1.b10, J3.71 (P45)
/SMART_IN10: J1.b11, J3.70 (P46)
/SMART_IN11: J1.b12, J3.69 (P47)
/SMART_IN12: J1.b13, J3.68 (V24_31)
/SMART_IN13: J1.b14, J3.67 (V48_55)
/SMART_IN14: J1.b15, J3.66 (P48)
/SMART_IN15: J1.b16, J3.65 (P49)
/SMART_OUT0: J1.c1, J3.9 (P31)
/SMART_OUT1: J1.c2, J3.10 (P30)
/SMART_OUT2: J1.c3, J3.11 (P29)
/SMART_OUT3: J1.c4, J3.12 (P28)
/SMART_OUT4: J1.c5, J3.13 (P27)
/SMART_OUT5: J1.c6, J3.14 (P26)
/SMART_OUT6: J1.c7, J3.15 (P25)
/SMART_OUT7: J1.c8, J3.16 (P24)
/SMART_OUT8: J1.c9, J3.17 (P23)
/SMART_OUT9: J1.c10, J3.18 (P22)
/SMART_OUT10: J1.c11, J3.19 (P21)
/SMART_OUT11: J1.c12, J3.20
/SMART_OUT12: J1.c13, J3.21 (P19)
/SMART_OUT13: J1.c14, J3.22 (P18)
/SMART_OUT14: J1.c15, J3.23 (P17)
/SMART_OUT15: J1.c16, J3.24 (P16)
GND: J1.a8, J1.a16, J1.a24, J1.a32
unnamed: U2.15 (GND), U2.16 (GND), U2.22 (GND), U2.51 (GND), U2.57 (GND)

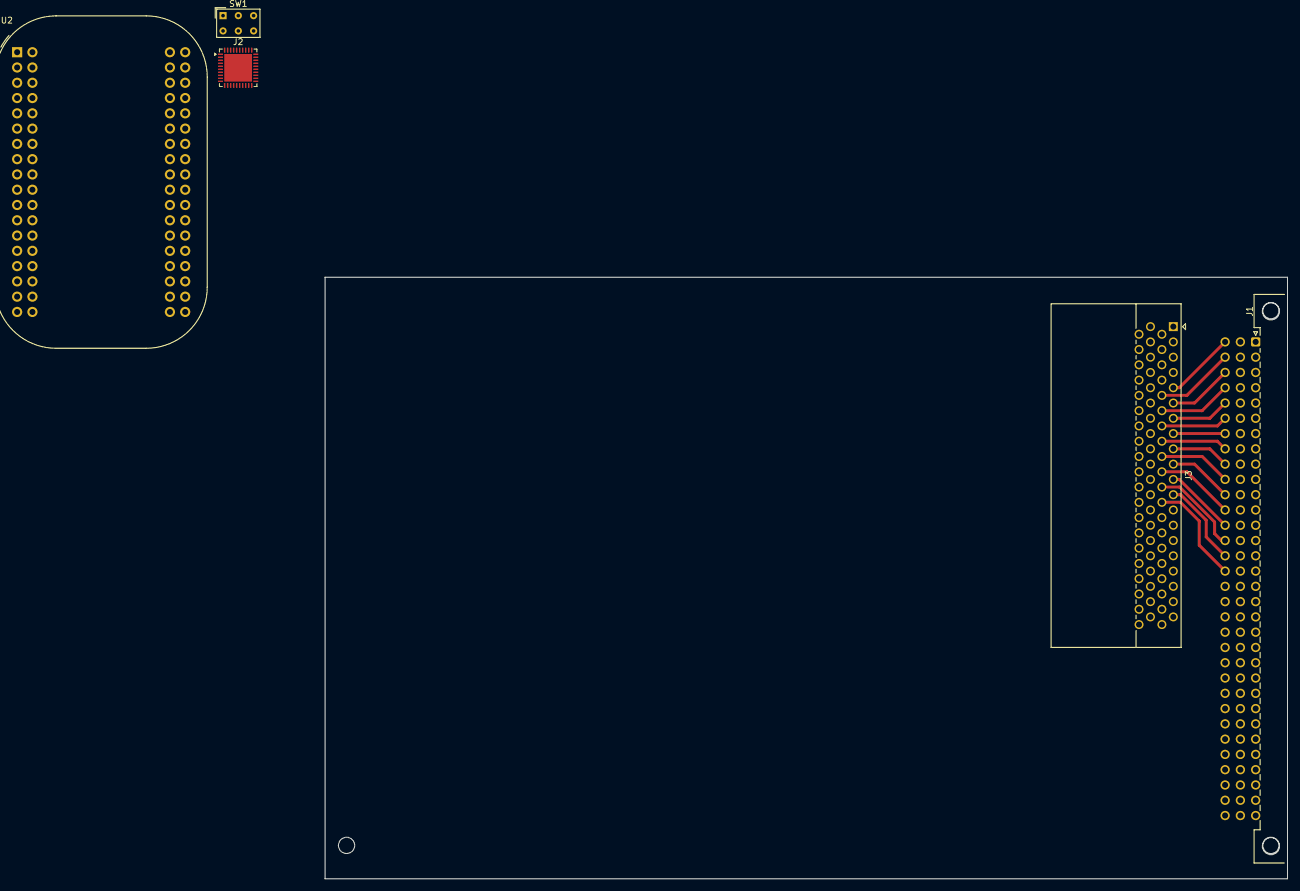
[picture p14: board main.kicad_pcb from above]

Board: 2 copper layers, 160.0 x 100.0 mm, 8 parts (0 on the bottom side), 34 nets.

Other parts of the board:
MH2, MH3, MH4: MountingHole_2.7mm_M2.5_DIN965
