ZigEmbeddedGroup/gauntlet/kicad/gauntlet.kicad_blocks/Card Connector.kicad_block/Card Connector.kicad_pcb

## KiCad design kicad/gauntlet.kicad_blocks/Card Connector.kicad_block/Card Connector.kicad_pcb (2026-07-07)

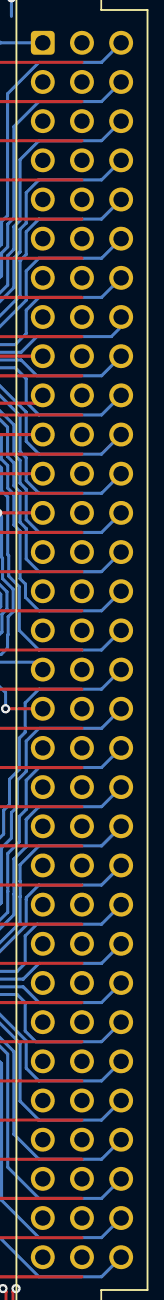
[picture p15: board Card Connector.kicad_pcb from above]

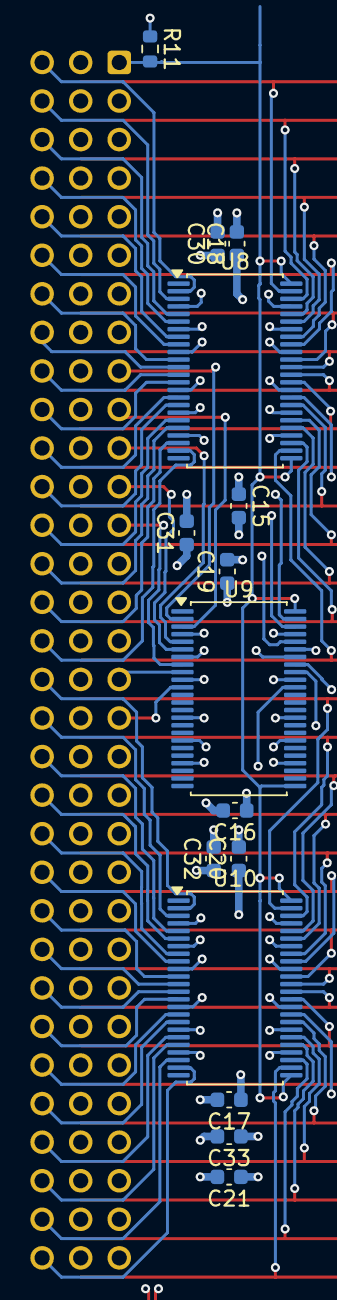
[picture p16: board Card Connector.kicad_pcb from below]

Board: 6 copper layers, 18 parts (15 on the bottom side), 43 nets.

Parts:
C15, C16, C17, C18, C19, C20, C21, C30, C31, C32, C33: 100n; C_0603_1608Metric
H2, H5: MountingHole; MountingHole_3.2mm_M3
J3: DIN41612_03x32_C_Split; DIN41612_C_3x32_Female_Vertical_THT
R11: 100k; R_0603_1608Metric
U8, U9, U10: SN74CB3Q16245; TSSOP-48_6.1x12.5mm_P0.5mm

Connections:
+3.3V: C15.1, C16.1, C17.1, C18.1, C19.1, C20.1, C21.1, J3.a7, J3.a15, J3.a23, J3.a29, R11.1, U8.7 (VCC), U8.18 (VCC), U8.31 (VCC), U8.42 (VCC), U9.7 (VCC), U9.18 (VCC), U9.31 (VCC), U9.42 (VCC), U10.7 (VCC), U10.18 (VCC), U10.31 (VCC), U10.42 (VCC)
+5V: C30.1, C31.1, C32.1, C33.1, J3.a6, J3.a14, J3.a22, J3.a28
/Card1/EEPROM_SCL: J3.a18, U9.11 (B6)
/Card1/EEPROM_SDA: J3.a17, U9.9 (B5)
/Card1/SLOW_IN0: J3.c17, U10.2 (B0)
/Card1/SLOW_IN1: J3.c18, U10.3 (B1)
/Card1/SLOW_IN2: J3.c19, U10.5 (B2)
/Card1/SLOW_IN3: J3.c20, U10.6 (B3)
/Card1/SLOW_IN4: J3.c21, U10.8 (B4)
/Card1/SLOW_IN5: J3.c22, U10.9 (B5)
/Card1/SLOW_IN6: J3.c23, U10.11 (B6)
/Card1/SLOW_IN7: J3.c24, U10.12 (B7)
/Card1/SLOW_IN8: J3.c25, U10.13 (B8)
/Card1/SLOW_IN9: J3.c26, U10.14 (B9)
/Card1/SLOW_IN10: J3.c27, U10.16 (B10)
/Card1/SLOW_IN11: J3.c28, U10.17 (B11)
/Card1/SLOW_IN12: J3.c29, U10.19 (B12)
/Card1/SLOW_IN13: J3.c30, U10.20 (B13)
/Card1/SLOW_IN14: J3.c31, U10.22 (B14)
/Card1/SLOW_IN15: J3.c32, U10.23 (B15)
/Card1/SMART_IN0: J3.c1, U8.2 (B0)
/Card1/SMART_IN1: J3.c2, U8.3 (B1)
/Card1/SMART_IN2: J3.c3, U8.5 (B2)
/Card1/SMART_IN3: J3.c4, U8.6 (B3)
/Card1/SMART_IN4: J3.c5, U8.8 (B4)
/Card1/SMART_IN5: J3.c6, U8.9 (B5)
/Card1/SMART_IN6: J3.c7, U8.11 (B6)
/Card1/SMART_IN7: J3.c8, U8.12 (B7)
/Card1/SMART_IN8: J3.c9, U8.13 (B8)
/Card1/SMART_IN9: J3.c10, U8.14 (B9)
/Card1/SMART_IN10: J3.c11, U8.16 (B10)
/Card1/SMART_IN11: J3.c12, U8.17 (B11)
/Card1/SMART_IN12: J3.c13, U8.19 (B12)
/Card1/SMART_IN13: J3.c14, U8.20 (B13)
/Card1/SMART_IN14: J3.c15, U8.22 (B14)
/Card1/SMART_IN15: J3.c16, U8.23 (B15)
/Card1/SWCLK_TCK: J3.a10, U9.3 (B1)
/Card1/SWDIO_TMS: J3.a9, U9.2 (B0)
/Card1/SWO_TDO: J3.a11, U9.5 (B2)
/Card1/TDI: J3.a12, U9.6 (B3)
/Card1/nRESET: J3.a13, U9.8 (B4)
/nCARD1: J3.a1, R11.2, U8.25 (~OE2), U8.48 (~OE1), U9.25 (~OE2), U9.48 (~OE1), U10.25 (~OE2), U10.48 (~OE1)
GND: C15.2, C16.2, C17.2, C18.2, C19.2, C20.2, C21.2, C30.2, C31.2, C32.2, C33.2, J3.a8, J3.a16, J3.a24, J3.a30, U8.4 (GND), U8.10 (GND), U8.15 (GND), U8.21 (GND), U8.28 (GND), U8.34 (GND), U8.39 (GND), U8.45 (GND), U9.4 (GND), U9.10 (GND), U9.15 (GND), U9.21 (GND), U9.28 (GND), U9.34 (GND), U9.39 (GND), U9.45 (GND), U10.4 (GND), U10.10 (GND), U10.15 (GND), U10.21 (GND), U10.28 (GND), U10.34 (GND), U10.39 (GND), U10.45 (GND)
